arturskotar/self-balancing-robot/(commit log)

2026-06-26 Initial commit: self-balancing robot V1 PoC
    IMU-only (GY-91/MPU9250) PD balancing firmware for a 2-wheel inverted
    pendulum, plus WSL build/flash tooling.
    - balance_v2/: fixed-rate PID controller with motor-deadband feed-forward,
    no slew limiter, empirical setpoint, safety cutoff
    - flash.sh / sync.sh: usbipd attach + Windows->WSL sync + compile + upload
    - README, WSL setup/sync guides, BOM, MIT license
    [balance_v2.ino]
2026-06-26 docs: make README self-contained for the public repo
    Drop references to the local-only WSL helper scripts and guides; keep a
    plain arduino-cli compile/upload/monitor flow.
2026-06-29 Working full-state self-balancer: encoders, velocity & position feedback
    Evolves the V1 IMU-only PoC into a robot that stands up, holds level,
    holds its spot, and recovers from nudges.
    Firmware (balance_v2.ino):
    - Wire the Waveshare DCGM-3865 Hall encoders (half-quadrature: rising-edge
    ISR on each A channel, B read for direction; ~546 counts/rev). Per-side
    ENC_*_DIR signs (right is mirror-mounted).
    - Add wheel-velocity estimate (VF, low-pass filtered) and position (POS,
    revs from boot/home) from the encoders.
    - Velocity damping (Kv) to stop drift and position hold (Kx, clamped) to
    return toward home -> full-state feedback on top of the pitch PD.
    - Low-pass the D-term gyro rate (D_LP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
    [balance_v2.ino]
2026-06-29 Add stall cutoff to protect motors when wheels are wedged
    If the controller commands hard drive (|u| > STALL_U_MIN) but the wheels
    aren't turning (|VF| < STALL_VEL_MAX) for ~1 s, the bot is wedged/fallen
    and the motors are just stalling (heat, current) -- cut them until it frees
    up. A balancing wheel always moves while u is large, so only a genuine
    stall trips this; recovery is automatic once the wheels can turn again.
    Edges are logged (STALL / STALL cleared). Gated behind STALL_CUTOFF (set 0
    to disable). Not flash-tested yet.
    [balance_v2.ino]
2026-06-30 Checkpoint: stable balancer after gyro-axis fix + from-scratch D re-tune
    Root cause of the recent instability: pitch-axis rate moved to the Y gyro
    (library axis change), so the controller was reading getGyroX() ~= 0 and
    flying blind on rate. Fixed: gyroRate = -(getGyroY() - GYRO_Y_BIAS).
    Because every gain had been tuned against that dead rate signal, re-tuned
    the D path from scratch:
    - Kd 4.5 -> 0.3 (4.5 railed the motors once rate was real)
    - Added MPU9250 on-chip DLPF 41->20 Hz to kill a motor-vibration DC bias
    (+14 deg/s phantom that offset the pitch estimate and held motors at the
    stiction floor)
    - D_LPF 0.6 -> 0.8 to keep the D term off the residual fast vibration
    State at this c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
    [balance_v2.ino]
2026-06-30 Working cascade balancer: stands up, recovers from drags
    Replaced the direct Kv/Kx velocity/position terms with a proper cascade:
    encoders -> a slow LEAN setpoint that the inner pitch loop chases.
    leanRaw = -(Kpos*positionRev + Kvel*forwardVel), clamped + low-passed
    error = pitch - (BALANCE_SETPOINT + leanCmd)
    The cascade never worked before only because its inner loop was reading the
    dead gyro; with the gyro fixed it is hand-tunable (no LQR needed). Key tuning:
    - LEAN_LPF 0.95 -> 0.99: 0.95 (~100ms) was faster than the pendulum's
    non-minimum-phase wrong-way transient -> positive feedback -> runaway. 0.99
    (~500ms) keeps the outer loop slower than the transient.
    - Kvel 2.0 -> 4.0: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
    [balance_v2.ino]
2026-06-30 Coast band: motors rest when balanced (kills jitter + saves motors)
    Widened the coast dead-zone 0.15 -> 1.0 deg and stopped gating it on gyroRate
    (which is corrupted by motor vibration and never let the coast engage). Now:
    within 1 deg of the leaned target AND wheels stopped -> command exactly 0.
    Result is better than just "rest the motors": the jitter was a self-sustaining
    loop (motors buzz -> vibration -> gyro reads it as motion -> motors buzz). With
    the motors cut at balance, the vibration stops, the gyro goes quiet (RATE falls
    from +/-35 to ~0), and it stays settled. Telemetry shows long runs of U 0 with
    RATE ~0 and the wheels frozen -- motors fully off, no current/heat/battery drain.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
    [balance_v2.ino]
2026-06-30 docs: sync README + CONTROL_THEORY to the final cascade + coast-band design
    The docs had drifted far behind the firmware. Brought both in line with the
    shipped controller and folded in the hard-won lessons from the tuning saga:
    - Cascade control law now shows the outer-loop low-pass (LEAN_LPF) and the
    coast band; gain table updated (Kd 4.5->0.3, Kpos 3->1, Kvel 6->4,
    LEAN_CLAMP 6->5, +LEAN_LPF 0.99, +ANGLE_DEADZONE 1.0, +GYRO_Y_BIAS, +DLPF).
    - New theory: the IMU pitch-axis-on-gyroY gotcha (§4.2); why Kd is *small*
    here and the on-chip DLPF (§7.3); the coast band as a self-sustaining-jitter
    breaker (§7.4); timescale separation / why LEAN_LPF must be slow or it runs
    away (new §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
2026-08-12 docs: Teensy 4.1 migration plan — closes the Arduino era
    Captures the V2 migration design and this session's electrical findings:
    - Encoder confirmed DC3.3V/DC5.0V w/ built-in pull-up -> power from 3V3,
    direct connect, no level shifting.
    - IBT-2 PWM is 3.3V-marginal (BTS7960 threshold ref'd to 5V Vcc): buffer
    with 74HCT244 or bench-verify; enables tied to 5V.
    - Final 2-rail power architecture (5V: Teensy+IBT-2 / 3V3: encoders),
    single-point ground, cut VUSB<->VIN pad for flash-over-USB.
    - Benefits (FPU, hardware QuadEncoder, 8 UARTs), IntervalTimer balance
    ISR, feature architecture (CRSF/ELRS, planning, LIDAR, telemetry),
    and the reasoned "not FreeRTOS yet" recommendation.
    Co-Au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
2026-08-12 docs(teensy): flashing pipeline + Uno->Teensy pinout mapping
    Flashing (§4.1): verified arduino-cli COMPILES Teensy (teensy:avr:teensy41)
    but cannot UPLOAD it over usbipd — Teensy re-enumerates to VID 16C0:0478 in
    HalfKay bootloader mode, breaking the attach mid-flash. Resolved by keeping
    the sync->build-in-WSL model but uploading via the Windows Teensy loader
    (teensy_post_compile.exe) called from WSL. Implemented in flash.sh, which is
    board-aware (--uno/--teensy). (flash.sh stays gitignored: machine-specific.)
    Pinout (§3.1): full Uno->Teensy 4.1 map. Motors 6/9 + 22/23 (paired FlexPWM
    submodules), encoders 2/3/4/5 on hardware QuadEncoder ch1/ch2, IMU on Wire
    18/19. Pins chosen to leave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
2026-08-12 fw(teensy): remap motor + encoder pins to the Teensy 4.1 map (§3.1)
    Motors: LEFT 6/9 (FlexPWM2.2 A/B), RIGHT 22/23 (FlexPWM4.0 A/B) — was the
    Uno's 5/6/9/10. Fixes the "only one motor drives" bench symptom: the wiring
    followed the new map but the flashed firmware still had the old pins, so only
    the overlapping pins 6/9 carried signal and the right motor (22/23) was dead.
    Encoders: 2/3/4/5 (were 2/4/3/7). Still attachInterrupt half-quadrature (works
    on any Teensy pin); pins are also hardware-QuadEncoder-capable for the future
    x4 upgrade. Comment fix: power the encoder at 3.3V on Teensy, NOT 5V — the
    built-in pull-up would otherwise drive 5V into a 3.3V input and damage it.
    IMU unchange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
    [balance_v2.ino]
2026-08-12 fw(crsf): standalone ELRS/CRSF receiver test + control mapping
    Hardware-verified against a RadioMaster RP1 (ELRS 2.4GHz) bound to a TX16S,
    read on Serial1 (pins 0/1) @ 420000 8N1. Hand-rolled parser: 0xC8 frame sync,
    CRC8-DVB-S2 check, 11-bit channel unpack. No external library.
    Control mapping (TX16S):
    - CH1 (right stick L/R) -> TURN
    - CH2 (right stick U/D, self-centering) -> DRIVE direction (-1..+1)
    - CH3 (throttle, rests at bottom) -> speed CAP (0.35..1.0), never disables drive
    - CH6 SB -> ARM (up only), CH7 SC -> gain select (Kp/Kd/Kvel)
    - CH8 S1 -> live-tune knob, clamped to a safe window per gain
    - Link loss -> failsafe (drive=0, disarm)
    Prints DRIVE/TURN/ARM/TUNE + raw CH1-8 for ben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
    [crsf_test.ino]
2026-08-12 fw(rc_drive): open-loop RC wheel-drive test (differential mix, arm-gated)
    Wheels-off-ground validation of the radio->motor path before folding drive into
    the balancer. Differential mix (left=drive+turn, right=drive-turn), per-side
    deadband (the pins-6/9 motor is stiffer -> bigger stiction kick), 20 kHz PWM for
    quiet running, arm(SB) + link-loss motor kill. Drive/turn axes inverted to match
    the sticks (up=forward, right=right).
    [rc_drive.ino]
2026-08-12 fw(crsf_test): invert drive + turn axes to match the sticks
    Stick up = +forward, stick right = +right (both were inverted). Keeps the
    convention consistent across crsf_test / rc_drive / balance_v2.
    [crsf_test.ino]
2026-08-12 fw(balance): integrate CRSF kill-switch + live gain tuning
    crsf.h: minimal ELRS/CRSF reader on Serial1 (same parser verified in crsf_test),
    exposed as crsf::armed/gainSel/knob01/drive/turn.
    balance_v2:
    - KILL SWITCH: the balancer runs ONLY when armed (radio linked AND SB up).
    Disarm, radio-off, or link-loss -> motorRaw(0) instantly, integral + lean
    reset, re-home. Hardware-verified: SB off = dead, SB on = balances.
    - Live tuning: SC selects Kp/Kd/Kvel, S1 knob sets it within a safe band
    centered on the shipped value (knob center = shipped), pickup-style so flipping
    SC never jumps a gain. Telemetry prints ARM + live Kp/Kd/Kvel.
    Behavior change: no radio = no balancing (by design).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
    [balance_v2.ino, crsf.h]
2026-08-12 fw(balance): RC drive + steering (turn works; forward pending 3.3V->5V buffer)
    - Turn: differential on the per-wheel output (u +/- turnCmd), applied after the
    coast band -- WORKS (rotates in place). Balance is yaw-blind so it passes through.
    - Drive: lean-to-drive via the cascade outer loop. Drive stick -> target forward
    velocity; while driving the position hold is released (re-home) so station-keeping
    doesn't fight it. Coast band suppressed while commanding, else it swallowed the
    small drive lean.
    - Per-side deadband in the balancer too (pins-6/9 = 15, 22/23 = 11); crsf::speed()
    added for the CH3 speed cap.
    Forward drive does NOT roll yet: the balance loop's safe authority (~25 P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
    [balance_v2.ino, crsf.h]
2026-08-13 Rebuild drive as velocity-to-lean loop
    Assumption: best-practice balancing robots use driver velocity command through an outer PI/PID that outputs target lean; forward motion is validated negative on this chassis, so DRV -1 maps to negative target velocity and the velocity PI produces positive forward lean without direct motor feedforward.
2026-08-13 Raise wheel deadband for drive breakaway
    Assumption: the latest log shows the velocity-to-lean loop has the correct sign, but forward drive only produced U=1..3, which mapped to PWM in the teens with the old 15/11 deadband. Turning works because TURN_AUTHORITY adds about 25, reaching roughly 40/36 PWM, so use a 35 PWM per-wheel deadband floor as stiction compensation while leaving PID in control of sign and timing.
    [balance_v2.ino]
2026-08-13 Drive by direct lean target
    Assumption: for this chassis test, the pilot drive stick should command the balance PID target angle directly, while the PID remains solely responsible for motor effort. DRV -1 maps to positive forward lean, position hold is released while driving, and encoder velocity is logged only for observation rather than speed control.
2026-08-13 Restore measured motor deadband
    Assumption: the 35-PWM steady floor is amplifying small PID sign changes into roughly 70-PWM reversals. Restore the measured 15/11 per-wheel compensation so the inner balance loop can cross zero without a large relay-like kick.
    [balance_v2.ino]
2026-08-13 Blank IBT-2 inputs before reversal
    Assumption: rapid balance-effort sign changes can momentarily overlap or abruptly swap RPWM and LPWM. Force each powered reversal through both inputs low with a 2 us blanking interval, while leaving same-direction PWM updates delay-free.
    [balance_v2.ino]
2026-08-13 Set explicit 20 kHz motor PWM
    Assumption: balance_v2 should use the same known motor-carrier frequency as the validated rc_drive test. Configure every motor pin because Teensy pins 22 and 23 use separate PWM submodules; 20 kHz remains below the BTS7960 25 kHz limit.
2026-08-13 Log filtered rate and actual motor PWM
    Assumption: integer U telemetry hides the near-zero sign changes and deadband mapping suspected in the oscillation. Log floating-point controller effort, filtered D-term rate, and signed per-wheel PWM so the next test can distinguish sensor noise, control reversal, and motor-output behavior.
    [balance_v2.ino]
2026-08-13 Use bounded wheel breakaway pulses
    Assumption: loaded wheels may need about 35 PWM to start, but holding that as the permanent minimum creates a relay limit cycle. Apply it for 70 ms only after 120 ms of genuine idle, cancel it on PID reversal, then return to the measured 15/11 compensation.
    [balance_v2.ino]
2026-08-13 Calibrate gyro bias at startup
    Assumption: the MPU9250 zero-rate offset varies with unit and temperature, and a fixed -9 deg/s bias can leak into both pitch and derivative effort. Measure 400 motors-off samples, reject noisy calibration above 2 deg/s standard deviation, and retain -9 only as a fallback.
    [balance_v2.ino]
2026-08-13 Bound vibration-driven derivative effort
    Assumption: motor-on RATE spikes around 40-55 deg/s are largely vibration and can contribute 12-16 effort at Kd 0.3, repeatedly reversing the wheels. Cap only the D contribution at +/-8 while preserving proportional and total motor authority, and log DTERM for validation.
    [balance_v2.ino]
2026-08-13 Correct per-wheel deadband guidance
    Assumption: deadband measurements must remain per-wheel because the two motors have different breakaway thresholds; remove stale references to the deleted shared MOTOR_DEADBAND setting.
    [balance_v2.ino]
2026-08-13 Restore full derivative damping
    Assumption: the latest log proves the large RATE values are real body motion during 20-30 degree swings, not merely motor vibration. The +/-8 D-term cap therefore removed required braking authority; retain DTERM telemetry but restore the original Kd times filtered-rate response.
    [balance_v2.ino]
2026-08-13 Remove steady per-wheel PWM bias
    Assumption: the observed dominant physical right wheel corresponds to the side receiving the extra four-count deadband compensation. Use equal 11/11 steady floors so equal balance effort produces equal PWM; retain the equal bounded breakaway pulse for startup.
2026-08-13 Reject turn cross-axis during straight drive
    Assumption: the latest straight-drive log shows TRN around -0.20 to -0.25, creating enough differential effort to cancel one wheel while the other drives. Use an independent 0.30 turn deadzone while preserving the 0.15 drive deadzone and full intentional turn authority.
2026-08-13 Reduce direct drive lean authority
    Assumption: a persistent 6-degree target-angle shift is too aggressive for this chassis and makes full-stick drive dominate the inner balance loop. Start at 2 degrees and constrain live tuning to 1-3 degrees so movement remains recoverable.
2026-08-13 Log post-deadzone turn effort
    Assumption: raw TRN telemetry will still show the measured gimbal cross-axis even when the controller rejects it. Log TCMD separately so the next test proves whether differential motor effort is truly zero during straight drive.
2026-08-13 Increase bounded wheel breakaway pulse
    Assumption: equal 25-33 PWM commands with zero encoder motion mean the previous 35 PWM / 70 ms pulse was insufficient to break the loaded wheels free.
2026-08-13 Arm wheel breakaway on drive onset
    Assumption: balancing effort can already be active when the drive stick moves, so idle-only breakaway arming can miss the command transition and leave both loaded wheels below their movement threshold.
2026-08-13 Revert drive breakaway experiment
    Assumption rejected: forcing a 42 PWM breakaway pulse at drive onset disrupts the pitch controller and makes balancing unsafe; restore the prior idle-only 35 PWM / 70 ms behavior.
    [balance_v2.ino]
2026-08-13 Restore symmetric balance output mapping
    Assumption: timed breakaway pulses and per-wheel deadband differences were contaminating the neutral pitch loop; restore one measured 11 PWM floor for both wheels while retaining differential steering and reversal blanking.
    [balance_v2.ino]
2026-08-13 Restore idle velocity damping
    Assumption: validated forward-negative encoder motion requires positive Kpos and Kvel feedback to request an opposing lean; applying this only at neutral restores recovery damping without fighting direct drive lean.
2026-08-13 Add end-to-end balance telemetry
    Assumption: preserving explicit 20 kHz, 8-bit setup on all four hardware FlexPWM pins is valid, while logging raw sensors, PID terms, wheel efforts, encoder deltas, lean components, radio inputs, and controller state will isolate any remaining regression.
2026-08-13 Rebuild drive as a setpoint-tracking cascade; fix PWM frequency
    The forward-drive failure had two root causes, both found by diffing
    against 9f13160 (the last known-good balance) and reading the BTS7960
    datasheet rather than inferring from behaviour.
    1. PWM frequency. The BTS7960 has a large input->output turn-on delay
    (datasheet 4.2.3): ~5.5us + ~2.5us rise at the IBT-2's 10k slew
    resistor, so pulses shorter than ~8us produce no output at all. At
    the Teensy default 4482 Hz one PWM count is 0.875us, so ~9 counts
    clear it -- matching the measured deadband of 11. At the 20 kHz set
    in a7480d9 one count is 0.196us, so ~41 counts are needed --
    matching the measured "~40 PWM to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
    [balance_v2.ino]
2026-08-13 Add outer-loop kill switch to isolate the forward runaway
    First armed run diverged: over 2.8 s PITCH climbed -0.65 -> +7.83 while
    TARGET fell -3.29 -> -6.00, so the gap widened monotonically from 1.6
    to 13.8 deg. Nothing oscillated -- every quantity moved one way. The
    inner loop was commanded to lean back to -6 deg and the body went to
    +7.8 instead. The sticks were never touched (DRAW/TVEL zero on every
    line), so this was not a drive test.
    That leaves two candidate faults and the log cannot separate them:
    a) The outer loop gain is too high and it drags the target away
    faster than the inner loop can follow. Kvel = 4.0 means 0.68 rev/s
    alone commands 2.7 deg of lean, over half of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
    [balance_v2.ino]
2026-08-13 Confirm all four sign chains from the hand-tilt test
    The previous commit read the 2026-08-13 log as an autonomous runaway.
    It was not: the run was a manual sign-verification with the sticks
    untouched, so the rising PITCH was the operator tilting the robot, not
    a divergence. The off-axis gyro activity agrees -- GZ swings +14.4 to
    -11.5 and GX reaches 11.7, which a robot rolling on a flat floor would
    not do. The controller driving the wheels forward under a growing
    forward tilt is the correct response, not a fault.
    Verified from that log:
    encoders rolling forward counts UP on both wheels (556 / 515), so
    forward = positive. The ENC_*_DIR flip was right.
    inner loop PITCH +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
    [balance_v2.ino]
2026-08-13 Restore per-side motor deadband (11 L / 13 R)
    The 2026-08-13 log shows the wheels need different breakaway floors.
    Summing per-window encoder deltas, the left wheel ran 21% ahead of the
    right below ~23 PWM but only 4% ahead above ~30 PWM. A gap that closes
    once both wheels are moving is a deadband difference, not a gain
    difference, and it matches the earlier bench measurement of ~11 L /
    13 R. Symptom it fixes: veering while creeping, tracking straight at
    speed.
    mapEffortToPwm() now takes the floor as an argument rather than reading
    a single global. The compensation stays STATIC -- no time-dependent
    breakaway pulses back into the pitch loop, which is what made the
    abandoned balancing-tuned b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
    [balance_v2.ino]
2026-08-13 Correct DEADBAND_TEST to measure loaded breakaway, not free-spin
    The first stick-engaged run showed the cascade working end to end: the
    outer loop asked for 4.4 deg of lean and the inner loop delivered it to
    within 0.69 deg. The robot still did not move -- ENC L 8 R 4 with zero
    per-window deltas for seven seconds while leaning.
    The log brackets why. PWM 15/17 produced zero encoder counts while the
    robot bore its own weight, and PWM 12/14 likewise once the lean was
    reached, but 34/39 during a turn rolled the wheels freely. So loaded
    breakaway is somewhere in 17..34, against deadbands of 11/13.
    Those 11/13 came from DEADBAND_TEST, whose instructions said to run it
    with the wheels off the gro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
    [balance_v2.ino]
2026-08-13 Fix inverted drive axis at the source in crsf.h
    Confirmed on hardware: pushing the stick forward gives DRAW -1.00, so
    crsf::drive() was returning -1 for forward -- the opposite of the
    contract stated in its own comment one line above ("Up = +forward").
    That surfaced as TVEL -0.60, a reverse command, while the pilot was
    pushing forward.
    On this TX16S setup CH2 reads above 1500 when the stick goes forward, so
    the raw (us-1500) term is already positive and the extra negation was
    wrong. Removed it.
    Fixed in crsf.h rather than by flipping DRIVE_SIGN so that drive() now
    matches its documented contract and DRIVE_SIGN stays a pure chassis-
    wiring knob. Flipping both would have left two negations c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
    [balance_v2.ino, crsf.h]
2026-08-13 Split the friction floor by wheel motion; fix setpoint windup
    The stick-engaged run confirms the drive axis fix -- forward stick gives
    TVEL +0.32 and TARGET leans forward from -3.21 to -1.70 -- and shows
    exactly why nothing rolls.
    Drive commanded 11/13 rising to 13/15 and the encoders never moved. The
    turn, in the same log, commanded 14..25 on one side and that side rolled
    immediately. Breakaway under load is around 16..20, and drive never
    reaches it; the turn only works because the differential adds to one
    side and pushes it over. Stick-slip is severe: PWML 19 gave DL 0 one
    window, PWML 16 gave DL -6 the next.
    So the two deadband measurements that looked contradictory are both
    right, they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
    [balance_v2.ino]
2026-08-13 Judge wheel motion by net displacement, not by any tick
    The wheelMoving detector added in the previous commit is wrong under
    stick-slip, which is exactly the regime it was built for. It marked a
    wheel as moving if the encoder changed at all within 50 ms. During
    stick-slip the encoder emits a continuous stream of +1/-1 ticks that sum
    to nothing, so the test read "moving" and selected the low Coulomb floor
    at precisely the moment the wheel was stuck and needed the static
    breakaway kick.
    The oscillation log shows it plainly: DL alternated -1/+1 for four
    seconds of full drive command, ENC L travelled from -21 to -31 in total,
    and DBL reported 11M throughout. The 18 static floor never engaged on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
    [balance_v2.ino]
2026-08-13 Set measured breakaway floors: 15 left, 27 right
    Loaded DEADBAND_TEST result. The right wheel needs nearly double the
    left to break away:
    PWM 14 -> dL -1 dR -1
    PWM 15 -> dL -6 dR -1 left breaks free, then accelerates
    PWM 20 -> dL -39 dR -3
    PWM 26 -> dL -95 dR -4 right still dead
    PWM 27 -> dL -119 dR -8 right finally breaks free
    The equal 18/18 floors straddled that gap -- left above its threshold,
    right below its own -- which accounts for the entire drive history in
    one fact. Commands of 13..15 moved nothing. The stick-slip oscillation
    was the left wheel intermittently breaking free near 15..18 while the
    right stayed locked. Turning worked only because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
    [balance_v2.ino]
2026-08-13 Filter drivetrain resonance before pitch control
    Lower the MPU9250 gyro and accelerometer DLPFs to 10 Hz after telemetry placed the motor-driven resonance at the previous 20 Hz corner. Return DEADBAND_TEST to normal operation after recording the loaded thresholds.
    Assumption: the added sensor delay remains compatible with the near-perfect neutral balance and suppresses more derivative noise than phase margin it costs; revert this commit first if neutral recovery degrades.
    [balance_v2.ino]
2026-08-13 Add bounded torque assist at drive onset
    On a fresh non-zero drive command, add up to four common-mode effort units in the direction currently requested by the inner pitch loop. End the assist when both encoders confirm net motion or after 250 ms, and expose START/BOOST telemetry.
    Assumption: the hand-push result means the cascade and moving-wheel authority are sound, while the remaining launch failure is insufficient margin over loaded static friction, especially on the right drivetrain. The inner balance loop remains the sole authority over motor direction.
    [balance_v2.ino]
2026-08-13 Delay drive assist until the lean is established
    Arm launch assist on a fresh drive command, wait until the cascade has established the requested lean and the body is near that target, then enforce a short axle-effort floor in the requested travel direction. Abort on excessive pitch error or rate, release on measured forward motion, and expose wait/push phases in telemetry.
    Assumption: the latest log shows the cascade reaching about 2.9 degrees of commanded lean while the old 250 ms assist has already expired; derivative-driven direction reversals then leave forward velocity near zero. A delayed one-shot pulse should reproduce the successful hand push without changing standing balance or pu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
    [balance_v2.ino]
2026-08-13 Correct encoder feedback polarity from autonomous drive data
    Flip both per-side encoder multipliers so a physical forward wheel catch reports positive counts, matching positive target velocity and the cascade equations. Correct the stale ISR comment and print the target/encoder/PWM sign convention at startup.
    Assumption: the inner balance direction is already validated and negative PWM is its physical forward catch. In the latest autonomous log, sustained negative PWM produces negative encoder deltas while positive-PWM rebound produces positive deltas, proving the current -1/+1 encoder multipliers invert physical forward. The earlier hand-tilt test was confounded by operator motion and coul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
    [balance_v2.ino]
2026-08-13 Restore neutral target after drive release
    Re-anchor the position setpoint to measured position when the drive stick returns to neutral, preventing a failed launch from leaving the position error pinned at its clamp. Require 100 ms of sustained commanded-direction velocity before launch assist exits, so an oscillation spike cannot masquerade as successful breakaway.
    Assumption: the latest log shows clean idle balance before drive, then PERR remaining at 0.499 after release while STATE COAST suppresses motor output. It also shows START W disappearing after a brief velocity reversal rather than sustained travel. The 1.0-degree coast band is not changed because it is disabled during STATE DRIV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
    [balance_v2.ino]
2026-08-13 Limit derivative kick during drive breakaway
    Assumption: the latest no-motion log shows the outer lean target is correct, while vibration-driven D spikes dominate P and reverse the axle before sustained motion begins. Preserve full derivative damping for neutral balance, confirmed rolling, and larger recovery errors.
    [balance_v2.ino]
2026-08-13 Gate drive launch on measured body lean
    Assumption: launch assist was entering from the commanded lean while the chassis remained nearly upright, so the forward pulse arrived before the body was in a catchable forward lean and immediately triggered a rate abort. Require measured lean and expose the latched launch exit reason.
2026-08-13 Prevent launch assist from reversing balance effort
    Assumption: the captured START P sample proves the breakaway floor changed a +4.2 recovery command into -4.0, causing the immediate pitch reversal and gyro abort. Permit launch assist only when the inner loop already commands the requested travel direction.
    [balance_v2.ino]
2026-08-13 Correct encoder polarity from unpowered push test
    Assumption: the user-confirmed physical forward push with both motor PWMs at zero is authoritative; it produced negative counts on both transformed encoders, proving both encoder direction constants were inverted. Flip them so physical forward, target velocity, and measured velocity are all positive.
    [balance_v2.ino]
2026-08-13 Increase gated drive launch authority
    Assumption: the latest ground log is authoritative: after the body reached the requested forward lean, the existing launch floor produced about -19/-31 PWM for 200 ms but neither encoder advanced. Raise only the gated launch effort from 4 to 10, yielding about -25/-37 PWM, while leaving neutral balance, rotation, PID gains, and normal output mapping unchanged.
2026-08-13 Keep drive launch armed through balance recovery
    Assumption: the reverse-push/forward-stick log is authoritative. The cascade correctly commanded maximum forward lean, but the inner loop needed about two seconds to recover a 14-15 degree backward lean; LAUNCH_WAIT_MS expired just before the body reached the safe forward-catch state. Keep WAIT_LEAN armed while the stick remains commanded and rely on the existing lean, error, rate, direction, and release gates to decide when the bounded assist may run.
    [balance_v2.ino]
2026-08-13 Count launch assist only while direction is eligible
    Assumption: the latest reverse-push/forward-stick log is authoritative. WAIT_LEAN persisted as intended, but PUSH began during a brief eligible sample, then spent its entire 200 ms timeout while the inner PID pointed backward and BOOST remained zero; it expired exactly when forward catch effort appeared. Replace wall-clock timeout with a 40-tick eligible budget, defer back to WAIT_LEAN when PID direction disagrees, and log the remaining BTK budget.
    [balance_v2.ino]
2026-08-13 Re-anchor drive trajectory at pilot takeover
    Assumption: stale station-keeping position error must not oppose a fresh drive command. The latest forward-push log showed negative PERR holding the lean command backward for about 700 ms after forward stick, so reset the position target to measured position at command and direction transitions while preserving normal cascade integration afterward.
    [balance_v2.ino]
2026-08-13 Give the velocity loop persistent drive authority
    Assumption: the latest tests show that target lean is reached but the PD angle loop then averages to nearly zero axle torque, so a bounded velocity-error torque term is required after the requested lean is safely established. Keep neutral balance unchanged, never stack with launch assist, and leave overspeed braking to the angle cascade.
    [balance_v2.ino]
2026-08-13 Hold drive torque through normal pitch motion
    Assumption: the latest log shows VTRQ contributes useful forward effort but the strict 10 deg/s engagement gate drops it on nearly every intervening sample, turning the supposedly persistent term into another pulse train. Engage under the original strict conditions, then retain it within the existing wider balance abort envelope and release it on unsafe motion, lost lean, overspeed, command release, or direction change.
2026-08-13 Restore full pitch damping during drive
    Assumption: the latest held-stick log shows the drive torque path now contributes, but pitch rate grows to roughly +/-50 deg/s while the drive-only derivative limiter clips a required +/-14 effort to +/-3. Neutral balance already uses the full derivative successfully, so preserve the same inner PD law during drive and test this independently of gains, deadbands, signs, and launch behavior.
2026-08-13 Disable redundant drive launch pulse
    Assumption: the safety-gated persistent velocity effort now reaches the measured breakaway range, so the one-shot launch pulse is redundant. The latest inertia log showed it firing after speed recovery and injecting another kick into an already-moving catch. Keep neutral balancing, signs, gains, and full derivative damping unchanged.
2026-08-13 Remove post-PD drive torque from the cascade
    Assumption: the stalled-drive oscillation is caused by the inner angle loop cancelling the safety-gated velocity effort. With VTRQ near -6 and Kp 2, cancellation requires about -3 degrees of error, beyond the 2.5-degree hold gate, so the term repeatedly disengages and re-engages. Keep the legacy path compile-disabled for A/B comparison; do not change neutral PID, signs, deadbands, or PWM.
    [balance_v2.ino]
2026-08-13 Increase commanded drive lean within existing limit
    Assumption: the latest stalled-drive log shows VERR near 0.6 rev/s producing only about 3 degrees of requested lean, while the inner P term remains smaller than the drivetrain-induced derivative ring. Double velocity-to-lean gain only during an active translation command, retain Kvel 4 at neutral, and preserve the existing slow lean filter and 5-degree clamp.
    [balance_v2.ino]
2026-08-13 Add a non-repeating breakaway pulse
    Assumption: the latest log proves the cascade reaches and holds its 5-degree drive target while stopped, but alternating inner-loop effort never sustains either PWM direction long enough to cross loaded stiction. Apply one measured 20-effort pulse only after the lean is established and settled, cap it at 200 ms, abort on lost lean/error, and enter a done state on every exit so it cannot re-fire during a held command.
    [balance_v2.ino]
2026-08-13 Give the inner loop drive-specific wheel authority
    Assumption: translation is weak because the outer loop only requests lean and Kp 2 turns the resulting small angle error into roughly 5-10 effort, while turning injects up to 25 effort directly. Blend inner proportional gain toward 4 only during commanded translation so larger catch errors can produce turn-class common-mode wheel power; retain Kp 2 and Kd 0.3 at neutral.
    [balance_v2.ino]
2026-08-13 Arm breakaway assist through the RC ramp
    Assumption: the launch pulse never fired because a normal stick gesture first produced TVEL 0.14, below the 0.30 strong-command threshold, and permanently entered LAUNCH_DONE before full stick arrived. Keep the launch state waiting through sub-threshold samples and require the strong threshold only when starting the pulse; moving authority and neutral balance remain unchanged.
2026-08-13 Raise drive-specific catch authority
    Assumption: Kpeff 4 remains too weak against strong longitudinal inertia because the latest drive log peaks at only 15.58 common-mode effort, below the turn mixer's 25 despite a 110 PWM ceiling. Raise only the translation-specific proportional target to 6 so 4-6 degree catch errors produce 24-36 effort; preserve neutral Kp 2, Kd, lean limits, signs, and launch behavior.
    [balance_v2.ino]
2026-08-13 Decouple drive catch authority from speed cap
    Assumption: the speed knob should limit requested velocity, while full stick must retain the inner loop authority needed to catch the resulting lean.
2026-08-13 Keep launch assist subordinate to balance
    Assumption: breakaway compensation may strengthen an inner-loop command in the requested direction, but must never reverse an opposing balance correction.
    [balance_v2.ino]
2026-08-13 Reduce drive damping near the commanded lean
    Assumption: the large alternating gyro-rate term near a tracked drive angle is vibration-driven and masks proportional drive authority; full neutral damping must return smoothly by three degrees of tracking error.
    [balance_v2.ino]
2026-08-13 Lower near-target drive derivative gain
    Assumption: the remaining launch oscillation is caused by vibration-driven derivative effort still cancelling proportional drive authority near the commanded angle, while full Kd above three degrees preserves push recovery.
    [balance_v2.ino]
2026-08-13 Add damping to the established drive response
    Assumption: after derivative attenuation restored drive authority, the remaining held-stick oscillation is an underdamped pitch response, and a 0.05 near-target Kd preserves authority while damping it.
    [balance_v2.ino]
2026-08-13 Restore the drive-authority derivative floor
    Assumption: increasing near-target Kd from 0.03 to 0.05 did not reduce the held-stick oscillation and reintroduced larger rate-driven floor reversals.
    [balance_v2.ino]
2026-08-13 Suppress friction-floor chatter during drive
    Assumption: the remaining held-stick oscillation is sustained when sub-3 PID effort reversals are expanded into full per-wheel deadband compensation, while larger corrections provide the required inertia authority.
    [balance_v2.ino]
2026-08-13 Revert the symmetric drive output gate
    Assumption: zeroing small effort in both directions is invalid because zero PWM brakes the geared drivetrain and lets the robot remain statically parked at the saturated lean target.
    [balance_v2.ino]
2026-08-13 Bias stalled drive effort without masking balance
    Assumption: after the leaned target is reached, gearbox friction can park the robot at zero PID effort; a minimum same-direction stiction torque plus suppression of only tiny opposing floor kicks will initiate rolling while preserving larger balance corrections.
    [balance_v2.ino]
2026-08-13 Raise the stalled-drive stiction bias
    Assumption: the 1.0 effort bias lands at the measured breakaway edge and cannot establish rolling before the pitch loop recovers; 3.0 provides a small margin while the existing near-target, velocity, and full-correction safety gates remain in force.
    [balance_v2.ino]
2026-08-13 Hold commanded torque through safe launch error
    Assumption: with DRIVE_KP=6, normal sub-1.25-degree tracking error creates 3.4-6.4 effort recovery pulses that escape the old 3.0 gate and cancel breakaway torque; suppressing up to 7.0 only inside the existing stalled-drive safety window should establish rolling while larger balance corrections remain untouched.
    [balance_v2.ino]
2026-08-13 Remove the stalled-drive output relay
    Assumption: the alternating drive response already crosses both measured friction floors, so forcing and sign-clamping effort around the zero crossing reinforces the observed 5 Hz limit cycle instead of solving breakaway.
    [balance_v2.ino]
2026-08-13 Restore damping across the drive mode
    Assumption: the measured 5 Hz, 1.5-degree oscillation is underdamped because DRIVE_KP=6 and DRIVE_KD=0.03 leave the rate term about six times too small; Kd=0.20 should damp the mode while preserving the drive-specific proportional authority and the neutral Kd=0.30 behavior.
    [balance_v2.ino]
2026-08-13 Remove saturated drive velocity gain
    Assumption: the drive-only Kvel multiplier feeds encoder ripple back into a lean request already clamped at five degrees, sustaining the remaining sign reversals; using the neutral Kvel gain should keep the outer loop linear while DRIVE_KP=6 retains inner-loop authority.
    [balance_v2.ino]
2026-08-13 Fix drive launch assist direction
    [balance_v2.ino]
2026-08-13 Add clamped drive velocity integral
2026-08-14 Add gentle velocity trim while driving
2026-08-14 Define velocity trim abort rate
2026-08-14 Increase gentle velocity trim
2026-08-14 Gate velocity trim during pitch recovery
2026-08-14 Raise outer-loop authority above the measured breakaway lean
    The 2026-08-14 stalled-drive log held full stick for 1.9 s with POS flat at
    0.535 +/- 0.005 -- zero travel against 1.14 rev commanded. The cause was an
    arithmetic ceiling, not a tuning shortfall: all three lean terms were capped
    independently, so the loop could not ask for more lean however long the stick
    was held.
    LEAN POS 0.50 PERR pinned at POS_ERROR_CLAMP 0.5, times Kpos 1.0
    LEAN VEL 1.80 Kvel 3.0 * velError, and with the wheels stopped velError
    is identically targetVel -- capped by construction
    LEAN VELI 0.80 saturated at VEL_I_CLAMP after 0.6 s, constant thereafter
    -------------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
    [balance_v2.ino]
2026-08-14 Bound the stalled-drive lean ramp after the ceiling theory failed
    Bench test of 85a778d falsified the premise it was built on. Earlier logs showed
    the robot motionless at leans of +0.50 and -3.7 deg, which was read as a friction
    threshold near 3.7 deg that the loop's 3.10 deg lean ceiling could never reach.
    Lifting the ceiling to 10 deg disproved it: the run reached a COMMANDED lean of
    8.4 deg and an ACTUAL pitch of 12 deg, and the wheels still netted +7 encoder
    counts over 3.1 s -- in the wrong direction, against a backward command. POS sat
    flat at 0.003 throughout. A robot stationary at lean X proves the threshold is at
    least X, not equal to X.
    The authority changes themselves worked exac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
    [balance_v2.ino]
2026-08-14 Fix the outer-loop hunt, and add full-rate capture plus a static lean test
    Two oscillations have been conflated. Separating them:
    SLOW HUNT (~1 s) outer loop. Lean builds, robot accelerates, velError closes,
    lean collapses, friction decays the speed, lean rebuilds.
    "Reaches the lean, forgets it, balances, again and again."
    FAST RING (5-35 Hz) inner loop. The PWM sign chatter that stops the wheels
    netting any travel.
    Evidence for the hunt, from the MS 16064-18764 segment: the robot held ~0.5 rev/s
    for 2.7 s with VERR 0.03-0.11 and LEAN CMD settled at 0.14-0.24 deg -- a correct,
    tiny cruise lean. Then VF fell 0.51 -> 0.21 -> 0.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
    [balance_v2.ino]
2026-08-14 Record two findings from the 2026-08-14 bench run
    Comments only; no behaviour change.
    1. VEL_I_ROLL_MIN is a catch-22. The gate requires rolling before the velocity
    integral may build, but the integral existed to help start the roll, so on a
    stalled drive VELI sits at 0.01 and contributes nothing. Measured ceiling:
    LEAN POS 3.00 + LEAN VEL 1.26 + VELI 0.01 = 4.27 deg (RAW read 4.10-4.47).
    LEAN_CLAMP 6.0 never binds; POS_ERROR_CLAMP binds again. The anti-windup
    argument still holds in isolation -- the fix is to let it accumulate while
    stalled and RESET on breakaway, not to block it beforehand.
    2. DRIVE_VELOCITY_EFFORT is enabled despite being documented as A/B-only, and it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
    [balance_v2.ino]
2026-08-14 Let the velocity integral build while stalled; disable the legacy trim
    Acts on the two findings recorded in bef0275.
    - Velocity integral: VEL_I_ROLL_MIN becomes a breakaway EDGE DETECTOR instead
    of an integrate gate. The integral now accumulates freely while stalled --
    which is when the extra lean is wanted -- and is discarded on the stall ->
    rolling transition, since whatever accumulated there was fighting stiction
    rather than trimming a cruise. Keeps the anti-windup property (no stiction
    wind carried into cruise) without the catch-22 of requiring the roll it was
    meant to start. Ramp is ~0.25 deg/s at full stick; raise KVEL_I if too slow.
    - DRIVE_VELOCITY_EFFORT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
    [balance_v2.ino]
2026-08-14 Arm the static lean test and switch the inner loop to D-on-error
    STATIC_LEAN_TEST 0 -> 1, and the lean is now applied continuously whenever the
    robot is armed rather than scaled by the stick, so the body holds a lean it
    should be falling out of for as long as SB is up. SB remains the bail-out.
    Two side effects the mode has to force, or the measurement destroys itself:
    - Coast band suppressed. With no stick, `commanding` is false, so the band
    would zero u the instant the body reached the commanded lean -- exactly when
    the measurement starts.
    - Burst capture arms on the ARM transition instead of the drive edge, since
    there is no drive edge in this mode. SB up = soft-start + 2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
    [balance_v2.ino]
2026-08-14 Set the drive envelope from the measured breakaway lean
    The static lean test plus the 200 Hz burst capture found the number this whole
    investigation was missing, and it was a FLOOR, not a ceiling.
    BREAKAWAY LEAN IS ~3.4 DEG. At a commanded 3.0 the robot travelled 0.245 rev --
    but only during the stand-up overshoot, while the ACTUAL lean was 6.5-7.6. As the
    inner loop settled the pitch onto its commanded 3.0, speed decayed with it:
    LEAN ACT 7.6 -> VF 0.20 LEAN ACT 4.1 -> VF 0.06
    LEAN ACT 6.5 -> VF 0.18 LEAN ACT 3.4 -> VF 0
    LEAN ACT 5.0 -> VF 0.11
    Every earlier drive log had a MEAN achieved lean of ~2.9-3.0, a few tenths under
    threshold. The commanded value looked adeq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
    [balance_v2.ino]
2026-08-14 Retire the static lean test; size the outer loop to the measured breakaway
    The static lean test is done. It answered all three questions it was built for:
    1. THE DRIVETRAIN WORKS. One run produced POS 0.000 -> 2.134 -- 2.13 rev of
    sustained monotonic travel at up to VF 0.65 rev/s. Closed.
    2. Breakaway is ~6-7 deg. The 3.4 deg figure from the first run was a coast
    artefact, measured while decelerating out of a stand-up overshoot.
    3. THE OBSTACLE IS THE STATIC/KINETIC FRICTION GAP. The same 6.0 deg command gave
    opposite outcomes on consecutive runs -- one stalled with POS frozen and
    LEAN ACT ~6.2, the other broke away and ran to LEAN ACT 18.9 with ERR 12.9 --
    and the second run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
    [balance_v2.ino]
2026-08-14 Cut time-to-breakaway so a standing start can reach the friction threshold
    FORWARD DRIVE WORKED for the first time. MS 32585-35909: POS 0.777 -> 1.371,
    0.59 rev in 3.3 s, with PWML/PWMR negative on all 33 samples -- no sign reversal,
    against every earlier log where it flipped every 100 ms. DFILT stayed inside +/-3
    throughout; the oscillation is simply absent while the wheels roll.
    The handover worked too. LEAN CMD climbed to 5.23, the robot accelerated, VERR
    closed from 0.20 to -0.00, and the lean came back down to ~4.8 on its own. That
    is the mechanism the static/kinetic bistability requires, working.
    What still fails is a FRESH STANDING START, seen on the reverse attempt from
    MS 37020: L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
    [balance_v2.ino]
2026-08-14 Bisect out the drive gain schedule: the 8.5 Hz stall is a limit cycle
    The 200 Hz burst capture finally resolved the stall oscillation, and it is
    neither of the things 100 ms telemetry suggested. It is a clean 8.5 Hz limit
    cycle created by the drive gain schedule and sustained by the deadband floor.
    Evidence from the 400-sample burst (armed on the drive rising edge):
    * Period: positive-run starts at i = 202,226,250,273,296,319,343,366 give
    deltas 24,24,23,23,23,24,23 = 23.4 samples = 117 ms = 8.5 Hz. Half-period
    is ~12 ticks, which also rules out the sign-hysteresis fix that was on the
    table -- 60 ms of held wrong-sign output is not survivable in a balancer.
    * Not chatter: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
    [balance_v2.ino]
2026-08-14 Make the launch assist continuous: friction feedforward aimed by velError
    The bench log showed the only mechanism that has ever moved this robot, and it
    is the launch assist, not the cascade. MS 33390-33590:
    MS DL DR VF START BTK
    33290 -1 0 0.01 W 40
    33390 +1 +3 0.06 W 40
    33490 +1 +5 0.09 P 36 <- assist PUSH fires
    33590 +4 +4 0.12 P 16
    33690 0 +1 0.03 C 11 <- released early, driveRollingConfirmed
    33790 -1 -2 -0.04 C 11
    It rolls while the pulse is on and dies within 200 ms of it ending. The assist
    exited with 11 ticks still on the clock: it saw 0.12 rev/s, declared bre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
2026-08-14 Fix the friction feedforward sign: aim it at u, not velError
    The velError-aimed bias from the previous commit had the sign backwards. The
    bench run confirmed both halves of that: the oscillation is gone, and the robot
    still cannot move.
    WHAT WORKED. u in the 200 Hz burst is a smooth curve, |rate| stays under 9, and
    there is nothing at 9 Hz anywhere in 400 samples. Taking the floor off the AC
    path really was what killed the limit cycle, so that diagnosis stands.
    WHAT BROKE. At burst i=399, u = +20.4 with FFB = -0.97 and floors 15/27:
    left : 15 * (-0.97) + 20.4 = +5.9 -> pwmL +6
    right: 27 * (-0.97) + 20.4 = -5.8 -> pwmR -4
    The bias and the PD cancel to nearly nothing, and b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
    [balance_v2.ino]
2026-08-14 Split the friction feedforward into LAUNCH and CRUISE phases
    The u-aimed bias got the lean up for the first time and then had nothing left to
    push with. Bench 2026-08-14:
    LEAN ACT reached 6.4 -> 9.9 deg tracking LEAN CMD 6.1 -> 8.5, |ERR| <= 1.5.
    Every earlier run had LEAN ACT pinned at -2.4 while the command climbed to 6.5.
    The body finally goes where it is told.
    POS stayed at 0.21 for the whole 1.3 s window. Lean up, wheels stopped.
    The burst explains it. u crosses zero at i = 46, 148, 241 -> ~195 samples = ~1 Hz,
    and across the whole capture u has essentially NO DC; it just swings +/-7.
    FRICTION_FF_LPF sits at 0.64 Hz, right on that, so FFB chased the swing (-0.62 to
    +0.65) rat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
2026-08-14 Overdrive the friction feedforward to the launch-assist magnitude
    The robot drove for the first time -- POS -0.625 -> 1.164, 1.79 revolutions -- but
    needed ~11 deg of lean to come unstuck, and climbing to 11 deg is what feels slow.
    The ramp itself is doing what it was sized to do; it just runs out. Measured:
    MS 29405 -> 29705, VELI 4.20 -> 5.00 5.0 deg/s
    MS 29705 -> 30205, VELI clamped at 5.00 1.9 deg/s
    The 5.6 deg/s target is real, it only lasts until the integral saturates ~1.5 s
    in, after which just Kpos*Vmax = 2.4 deg/s remains and the last few degrees crawl.
    Raising KVEL_I would not fix that -- it reaches the same clamp sooner and total
    time is set by the clamp value,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
    [balance_v2.ino]
2026-08-14 Let the robot attempt a stand-up, bounded by a give-up timeout
    Requested: recover from the logged "laying" pose. That pose is LEAN ACT 31.60 deg
    -- 1.6 deg past FALL_CUTOFF_DEG 30 -- so the fall latch had tripped and the robot
    was forbidden from even trying. The cutoff was the only thing in the way: at 31.6
    deg of error the PD asks for Kp*31.6 = 63 PWM against a 110 ceiling, authority it
    already has.
    FALL_CUTOFF_DEG 30 -> 45
    Beyond ~45 deg the accel pitch gets ambiguous and it really is on its back, so
    that is the new line.
    A stand-up attempt has to be BOUNDED or it cooks the motors against whatever the
    robot is lying on. Above ~39 deg of error the existing saturation latch already
    cov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
    [balance_v2.ino]
2026-08-14 Stop the friction FF phase from chattering; confine the boost to launch
    The boost re-introduced the oscillation, and the log shows the mechanism is the
    PHASE GATE, not the boost's magnitude. Consecutive 100 ms samples:
    45100 FFP C FFB +0.94 LEAN ACT -5.70 PWM +48/+63
    45200 FFP L FFB -0.83 LEAN ACT 0.60 PWM -36/-37
    45300 FFP C FFB +0.95 LEAN ACT -6.34 PWM +46/+48
    45401 FFP L FFB -0.69 LEAN ACT -0.22 PWM -28/-30
    LEAN ACT was ringing -6.6..+0.6, a 7 deg swing, while the enter/exit pair was
    3.0/1.5 -- a 1.5 deg band sitting entirely inside the ring. The phase flipped every
    tick, and because LAUNCH and CRUISE push in OPPOSITE directions by design, every
    flip is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
    [balance_v2.ino]
2026-08-14 Fix the one-wheel stall: common FF floor, and let CRUISE fall back to LAUNCH
    Two defects, one of them introduced by the previous commit.
    1. PER-WHEEL FLOOR IN THE FEEDFORWARD PATH. The FF bias is a common-mode drive
    command, but each wheel was scaling it by its own deadband. Because the FF can
    OPPOSE u, that differential lands as a net-zero wheel. Bench 2026-08-14, u =
    -28.50, FFB = +0.99, DBL 11M, DBR 27S:
    left : 11 * 0.99 - 28.50 = -17.6 -> PWML -17
    right: 27 * 0.99 - 28.50 = -1.8 -> PWMR -1
    ENC L ran 10 -> 267 while ENC R sat at 20. It is also self-reinforcing: the
    stopped wheel keeps the larger STATIC floor (27 not 13), which cancels more of u,
    which keeps it stopped.
    N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
    [balance_v2.ino]
2026-08-14 Let the lean command track the launch, and lead the LAUNCH->CRUISE gate
    The launch rotates the body about 20x faster than the outer loop's lean ramp, so
    the inner loop spent the whole launch fighting it. Bench burst, forward drive:
    i=0..5 PWM +47 (launch), pitch -3.52, rate 0
    i=6..15 rate 9 -> 93 deg/s, pitch -3.6 -> -0.6
    i=16 leanToward crosses 3.0 -> CRUISE, PWM +16 -> -60 in ONE TICK
    LEAN CMD was still 0.38 and climbing at 5.6 deg/s while the body did 100 deg/s.
    The inner loop therefore saw the body running away from a stationary target and
    drove u to -31 OPPOSING the launch, and the handover then reversed 76 PWM counts
    into a body already rotating at 100 deg/s. Peak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
    [balance_v2.ino]
2026-08-14 Revert the launch-overdrive line of work; drive authority from lean instead
    Reverts 8d71d16, 4013030, 1e41b3b and 268a8f7. fa7b812 (stand-up recovery) is
    unrelated and kept. The FF block is now bit-for-bit 28badb1 -- verified by diffing
    every friction/ffBias/gate line against that commit.
    WHY. 28badb1 drove 1.79 revolutions (POS -0.625 -> 1.164). The four commits after
    it all chased "more aggressive launch" and each one traded a working robot for a
    new failure:
    268a8f7 FF boost -> oscillation returned
    1e41b3b one-way latch -> phases scrambled
    4013030 common floor -> one wheel turning (real fix, still bad)
    8d71d16 launch lean + lead -> deadlock, zero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
    [balance_v2.ino]
2026-08-14 Kill the ramp crawl, restore the common FF floor, boost only when stalled
    It drives now -- POS 0.252 -> -0.762, about 1.0 rev, and LEAN ACT genuinely
    reaches -17.0 deg before VELI collapses -9.00 -> -0.10 at MS 139875 as the
    breakaway detector fires. So the answer to "FF our launch sequence?" is no: the
    lean gets there on its own and does not need an opposite-direction launch push.
    Three narrower things were eating the time instead.
    1. THE RAMP DIED INTO A CRAWL. Measured 8.5 deg/s from MS 137170 to 138675, which
    matches the 8.8 design, so the law is right. But VEL_I_CLAMP 9 pinned the integral
    after 1.5 s and the last 2.4 deg then took 1.1 s at Kpos*Vmax = 2.4 deg/s -- over
    40% of the tota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
    [balance_v2.ino]
2026-08-14 Blend the FF floor on speed instead of gating it on wheelMoving
    The oscillation is a gate I added last commit, keying off a fast noisy variable --
    the same class of error that has produced most of the failures this session.
    Two consecutive telemetry samples:
    MS 17360 u = -10.13 FFB 0.98 DBL 15S DBR 27S -> floor 27+20=47 -> PWM +36
    MS 17460 u = -37.06 FFB 0.96 DBL 15S DBR 13M -> floor 15 -> PWM -22
    ffFloor dropped 47 -> 15 in one tick because wheelMoving flickered on the right.
    TWO things keyed off that flag -- the static/moving floor choice and the new
    ffBoostOk -- so they compounded into a 32-count step in the floor. wheelMoving
    toggles at encoder-noise level (DBR alte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
    [balance_v2.ino]
2026-08-14 Slew-limit the FF floor; the blend window was smaller than the encoder quantum
    Last commit replaced a discrete gate with a "continuous" blend and it changed
    nothing, because the blend was not actually continuous. Third instance of the same
    mistake this session, and worth recording plainly.
    ONE ENCODER COUNT IS 0.366 rev/s (546 cpr, x1 decode, 200 Hz). VRL/VRR step in
    +/-0.37 quanta throughout every log. FRICTION_FF_ROLL_VEL was 0.15, so the blend
    window was 2.4x SMALLER than the quantum: ffRoll still slammed 0->1 on a single
    count and ffFloor still stepped 13 <-> 47. Burst, with u essentially unchanged
    across the tick:
    i=72 u 1.834 PWM 10 i=145 u 16.139 PWM 1
    i=73 u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
    [balance_v2.ino]
2026-08-14 Turn the friction feedforward off; settled as not salvageable
    DRIVE_FRICTION_FF 1 -> 0.
    The two-phase feedforward cannot be made to work. LAUNCH and CRUISE push in
    OPPOSITE directions, so any gate between them turns a misclassification into a
    full-amplitude PWM reversal rather than a small error. Every gate was tried:
    3.0/1.5 hysteresis chattered on the pitch ring
    one-way latch caught a transient, could never recover
    -2.0 deg loss threshold released only on an INVERTED lean, not an absent one
    0.04 s rate lead fired correctly, body still overshot
    Final run: FFP alternating C,L,C,L,C,C,L,C,L,... on every 100 ms sample with FFB
    flipping +0.94, -1.00, +0.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
    [balance_v2.ino]
2026-08-14 Ramp the stiction floor in instead of stepping to it
    With the feedforward off the robot drives and reverses cleanly, and the remaining
    oscillation is down to one mechanism with a clear signature.
    Burst: u peaks at i = 21, 46, 70, 94, 117, 142, 168, 193, 219, 245, 271, 296 --
    intervals of 23-26 samples, so ~125 ms = 8 Hz, +/-9 on u and only about +/-0.5 deg
    on pitch. On every cycle PWM steps 0 -> -16/-28 and 0 -> +15/+27.
    That step is the sign-of-u floor, and with the FF gone it is the ONLY nonlinearity
    left in the loop. As a step it has INFINITE incremental gain exactly at the zero
    crossing, which is where the loop spends its time -- the textbook describing-
    function recipe for a limit cyc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
    [balance_v2.ino]
2026-08-14 Raise DRIVE_MAX_VEL 0.40 -> 0.60
    Requested from the v2-drive-works state. Single-constant change so the test reads
    cleanly.
    This is NOT only a speed cap. Both outer-loop ramp terms scale with it:
    lean ramp = (Kpos + KVEL_I) * Vmax = 30 * 0.60 = 18 deg/s, up from 12
    LEAN_CLAMP 18 now reached in ~1.0 s instead of ~1.5 s
    So expect it to lean into a command noticeably harder, not just run faster. That is
    the same coupling that made the ramp feel slow at 0.25.
    Encoder resolution improves as a side effect: one x1 count is 0.366 rev/s at 200 Hz,
    so the full-stick target was BELOW one count at 0.25, about 1.1 counts at 0.40, and
    about 1.6 at 0.60. The velocity loop finally regulates agai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
2026-08-14 Brake while coasting: keep the velocity integral alive after stick release
    The integral was zeroed the instant the stick centred, which dropped the
    outer loop's braking authority from LEAN_CLAMP 18 deg to Kpos*posError +
    Kvel*velError -- measured at 1.8 deg, below the ~6-7 deg breakaway lean.
    The robot therefore could not brake at all on release; it coasted on rolling
    friction. From the 2026-08-14 log, stick centred at 0.44 rev/s: 0.35 rev
    over 1.7 s, ending parked with a permanent 0.25 rev position error.
    Keep integrating while the wheels are still rolling, stick or no stick. With
    targetVel 0, velError = -forwardVel, so the counter-lean ramps at KVEL_I*|v|
    = 10.6 deg/s and clears breakaway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
    [balance_v2.ino]
2026-08-14 Raise DRIVE_MAX_VEL 0.60 -> 0.90
    Reported: too slow, too sluggish, cannot overcome minor bumps.
    This is the target-limited case, not the authority-limited one. In the 0.60
    drive log the loop was tracking its target rather than straining against a
    ceiling: TVEL 0.56 vs VF 0.55, VERR 0.01, and LEAN RAW peaked at 9.43 against
    a LEAN_CLAMP of 18 that never bound on forward acceleration. The robot
    delivered exactly the speed it was asked for, so the request was what was low
    -- raising LEAN_CLAMP would have changed nothing on flat ground.
    Ramp scales with it too: (Kpos + KVEL_I)*Vmax = 27 deg/s, up from 18, so the
    clamp is reachable in 0.67 s instead of 1.0. Bumps ride the same term -- a
    bump dr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
    [balance_v2.ino]
2026-08-14 Cap LEAN_CLAMP at 12: the chassis sits down at 15.7 deg of rear lean
    Manual tilt sweep, disarmed, measured on the bench:
    forward rest pitch +27.31 = LEAN ACT +30.53 (held 1.2 s)
    rear settle pitch -18.89 = LEAN ACT -15.67 (damped settle, steady)
    rear hard pitch -27.29 = LEAN ACT -24.07 (held 2.0 s)
    The chassis has 30.5 deg of forward lean and only 15.7 deg of rear lean
    before it rests on its rear contact. LEAN_CLAMP 18 commanded pitch -21.22,
    2.3 deg PAST that -- so every full-reverse command drove the robot onto its
    own backstop and parked there.
    Observed three times: LEAN RAW pinned at -18, encoders frozen 1.2-3.0 s,
    pitch held at -20.6..-21.5 (free rest -18.89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
    [balance_v2.ino]
2026-08-14 Split LEAN_CLAMP per direction (18 fwd / 12 rear) and widen the CH3 range
    Two independent changes, both revertible on their own.
    1. LEAN_CLAMP -> LEAN_CLAMP_FWD 18 / LEAN_CLAMP_REAR 12.
    The symmetric 12 fixed reverse by starving forward. Measured in the next
    drive log: LEAN RAW pinned at exactly 12.00 for 4+ s of held forward stick
    while VELI kept climbing (7.42 -> 7.63) and PERR stayed open at 0.55-0.73 --
    the loop asking for more lean than allowed, in the direction that has 30.5
    deg of physical room. A symmetric clamp must be sized for the worse side and
    the two sides differ by 2x.
    Forward 18 is not a guess: it is the value in every good forward-drive log,
    and forward has never exceeded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
    [balance_v2.ino]
2026-08-14 Correct the record: the forward clamp evidence was tether-contaminated
    The USB tether was fouling the right wheel in the log cited by a2cc1f9. That
    drag held forwardVel at 0.15 against a 0.51 target, and a permanently open
    velError is exactly what winds VELI into the clamp -- so "LEAN RAW pinned at
    12.00" is an artifact, not proof that clean-ground forward needs more than 12.
    The split stands on the geometry instead: the chassis is measurably asymmetric
    (30.53 fwd vs 15.67 rear), so one number must be sized for the worse side and
    is wrong-shaped for the better one; 18 forward is the value every good
    forward-drive log ran at rather than a new guess; and it costs nothing
    measurable, since for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
    [balance_v2.ino]
2026-08-14 Speed up the outer loop: LEAN_LPF 0.97 -> 0.95
    Reported: braking from forward takes too long to take effect and the bot
    crashes sometimes; backward-to-forward is much better.
    This addresses the lag half only. tau = DT/(1-alpha) goes 167 ms -> 100 ms.
    Measured cost at 0.97 on a full reversal: leanRaw hit the clamp in 400 ms,
    then leanCmd needed another 700 ms to follow (-13.42 -> -17.94 = 4.3 tau,
    matching the model to two decimals). At 0.95 that tail is ~410 ms.
    Held at 0.95 rather than lower because the outer-loop corner moves 0.95 ->
    1.6 Hz against an inner loop closing around 3-5 Hz, which is already only
    2-3x separation.
    The direction asymmetry is NOT fixed by this and cannot be in so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
    [balance_v2.ino]
2026-08-14 Size DRIVE_MAX_VEL by stopping distance: 0.90 -> 0.65
    Braking from forward was taking too long and crashing. Root cause is
    arithmetic I failed to run when raising the speed: stopping distance goes as
    v^2 / (g*tan(theta_rear)), and the last few commits moved both terms the
    wrong way at once.
    was: Vmax 0.60, rear 18 deg -> 3.19 m/s^2 (braked acceptably)
    then: Vmax 0.90, rear 12 deg -> 2.09 m/s^2
    ratio = (0.90/0.60)^2 * (3.19/2.09) = 3.4x the stopping distance
    The 12 deg rear cap is not negotiable -- the chassis sits down at 15.67 --
    so speed is the only remaining term. Reference points at that cap, relative
    to the config that stopped well: 0.49 = same distance, 0.60 = 1.5x,
    0.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
    [balance_v2.ino]
2026-08-14 Revert LEAN_LPF to 0.97: rear margin is scarcer than response time
    0.95 was never flown. Rear overshoot is the binding resource, not lag: pitch
    overshooting leanCmd is what consumes the 3.7 deg between LEAN_CLAMP_REAR 12
    and the -15.67 sit-down, and a faster command rotates the body faster into
    the lean, so it overshoots more.
    0.97 is also the only alpha where that overshoot is measured -- 2.78 deg
    peak on the rear side, MS 32705 of the good brake log. Going faster
    invalidated the one number the rear clamp is sized against, in the dangerous
    direction.
    Exchange rate is still unmeasured: slower leanCmd buys usable rear lean at
    roughly 8.5% deceleration per degree, which may beat the lag it c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
    [balance_v2.ino]
2026-08-14 Shape the velocity demand: rate-limit targetVel away from zero
    The loop had no concept of braking -- it only tracked a setpoint, so when
    momentum opposed the command all three outer terms saturated at once and
    stayed there. From a real forward->reverse slam (MS 31590): LEAN POS -3.24,
    VEL -4.37, VELI -10.86, RAW -18.47 -> clamped. The integral was doing 59% of
    the braking; a term meant to trim a cruise had become the primary brake
    authority, and it is the slowest thing in the loop. velError sat at -1.25
    rev/s for the whole maneuver so VELI wound at 30 deg/s and pinned in ~0.4 s.
    That makes the brake bang-bang rather than proportional (max lean from 0.4 s
    until the velocity crosses, equally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
    [balance_v2.ino]
2026-08-15 Give balance priority over turn in the mixer
    Turning is differential (effortL = u + turn, effortR = u - turn), so the
    fore-aft force -- the sum -- is exactly 2u and turn cancels out of the pitch
    axis. That is why turning has never upset the balancer. But the cancellation
    only holds while neither wheel saturates.
    When one wheel hits MAX_PWM the clip is one-sided: u + turn is truncated and
    u - turn is not, the sum stops being 2u, and the turn differential leaks into
    common mode -- a direct pitch disturbance arriving exactly when the loop has
    no authority left to reject it. Wheel RPM saturation does the same: past the
    motor's speed limit extra PWM buys no torque, so the outer wheel silently
    st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
    [balance_v2.ino]
2026-08-15 Widen FALL_REARM_DEG 8 -> 12 so a latched fall can be cleared
    Reported: "it disables and doesn't read commands at all until I physically
    push it". Two halves; this fixes the second.
    Once `fallen` latches, nothing re-arms until the ABSOLUTE accel angle is back
    inside FALL_REARM_DEG of the setpoint. At 8 deg the robot had to be held
    almost perfectly upright to clear it. 12 still requires a deliberate stand-up
    -- the rear sit-down is 15.67 and the forward stop 30.53, so a robot that is
    genuinely down reads far outside 12 and cannot self-clear by lying there.
    FINDING, not yet fixed: the safety angles were all sized against LEAN_CLAMP
    18 and Kp 2.0, and cutting the rear clamp to 12 invalidated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
    [balance_v2.ino]
2026-08-15 Restore LEAN_CLAMP_REAR to 18: the -15.67 sit-down was not real
    Second manual sweep, disarmed, back-to-front: rear rest is PITCH -28.5 =
    LEAN ACT -25.3, held steady a full second, and the chassis swept straight
    THROUGH -18.9 on the way up at 34-42 deg/s with no pause. Forward agrees
    across both sweeps (+30.53 / +29.97), which is what made the rear
    disagreement easy to miss.
    The -15.67 I sized the rear clamp against was a dynamic settle in the earlier
    sweep -- wherever the torques happened to balance on that particular release
    -- taken during the period when the tether was fouling the right wheel. Not a
    hard contact. Everything built on it (dc2d3fe, and the DRIVE_MAX_VEL cut in
    0d95dee that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
2026-08-15 LEAN_CLAMP_REAR 18 -> 14: keep the command off the soft rear contact
    Stand-up is fixed but reverse stalls again, exactly as it did at 18 before.
    Reconciling the two sweeps: there are TWO rear contacts, and each sweep found
    a different one. A soft/compliant one around -19 to -21 (the first sweep
    settled at -18.89; the second swept through at 34-42 deg/s without pausing,
    which is what a compliant contact does to a fast hand sweep) and a hard rest
    at -25.3. So the earlier -15.67 was not pure artifact after all -- it was a
    real contact, just not the hard limit I sized against.
    At clamp 18 the commanded pitch is -21.22, inside the soft band, and every
    logged reverse stall parked at -20.6..-21.5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
    [balance_v2.ino]
2026-08-15 FLOOR_KNEE 5.0 -> 2.5: the rear stall is a breakaway dead zone, not a contact
    Clean tether-free reverse log settles it: the stall angle FOLLOWS THE COMMAND.
    Clamp 18 parked at pitch -20.6; clamp 14 parks at -17.2. There is no fixed
    rear obstacle -- the loop reaches whatever lean is asked for and then never
    breaks away. That retires the backstop theory chased across dc2d3fe,
    b4f5e3b and 7497034.
    Mechanism: pwm = deadband*(|u|/FLOOR_KNEE) + |u|, so at FLOOR_KNEE 5 the right
    wheel needs |u| >= 3.7 to reach its own 27-count static floor. Once pitch
    reaches target, ERR ~ 0 and |u| oscillates 0.15..3.7, flipping sign every tick
    or two. Peak PWM measured 23 against a breakaway of 27 -- never once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
    [balance_v2.ino]
2026-08-15 Enable DEADBAND_TEST to measure the 27-vs-15 breakaway asymmetry
    The right wheel's 27-count static floor against the left's 15 is the root of
    the rear stall (see FLOOR_KNEE), and it has never been measured directly.
    Run at MOTOR_PWM_HZ 4482, 2000, 1200 and fit
    deadband = t_on * f_pwm * 256 + mechanical
    Predicted driver-delay term at t_on ~8 us: 9.2 / 4.1 / 2.5 counts. If the
    floors fall by about that much, the gap is BTS7960 turn-on delay and a lower
    PWM frequency shrinks both; if they barely move it is real friction.
    Note the test ramps POSITIVE PWM only, which on this wiring is physical
    backward -- the same direction that stalls, so this measures exactly the case
    of interest.
    Must b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
    [balance_v2.ino]
2026-08-15 Deadband sweep: MOTOR_PWM_HZ 4482 -> 2000 for the second data point
    Free-spin breakaway at 4482 measured L@13 R@12, and L@14 R@13 on a repeat, so
    repeatability is +/-1 count.
    Two things that reads on already:
    - the 15/27 asymmetry in the config is NOT the motors or drivers. Off the
    ground both wheels break at the same PWM, so 15/27 is purely LOAD.
    - the predicted BTS7960 turn-on delay term at 4482 Hz is 9.2 counts against
    a measured free-spin floor of ~12.5, leaving ~3 for unloaded mechanical.
    About 75% of the floor is driver delay.
    If that holds, 1200 Hz should drop the free-spin floor to ~5-6 and take ~6.7
    counts off both loaded floors (15/27 -> ~8/20), which would attack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
2026-08-15 Deadband sweep: 1200 Hz, third point. Two-point fit revises t_on down
    Free-spin breakaway, wheels off the ground:
    4482 Hz L@13 R@12 (repeat L@14 R@13, so +/-1 count)
    2000 Hz L@11 R@9
    Two-point fit with dt = 1/(f*256), i.e. 0.872 us and 1.953 us per count:
    L: 2.5 counts of drop -> t_on ~3.9 us, mechanical ~9.0
    R: 3.5 counts of drop -> t_on ~5.5 us, mechanical ~6.2
    Turn-on delay is 4-5.5 us, not the ~8 us assumed from the datasheet figures,
    and the unloaded mechanical floor is 6-9 counts rather than ~3. So the driver
    term is smaller than predicted and mostly spent by 2000 Hz.
    Extrapolating to 1200 Hz (dt 3.26 us) predicts only L@10 R@8 -- about one more
    count. This third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
2026-08-15 Record the deadband sweep results and the left-channel anomaly
    L R
    4482 13 12 (repeat 14 / 13, so +/-1 count)
    2000 11 9
    1200 21 8
    R is a clean monotonic fit and 1200 landed exactly on the predicted 8. L is
    not monotonic -- a floor cannot rise as frequency falls -- so L@21 is a bad
    sample rather than a measurement.
    Blocking: at 1200 the log shows dL -14 (barely moved) and dR -358 (spun
    freely), but the pilot observed the RIGHT wheel barely moving. If the encoder
    channels are mislabelled, every left/right constant in this file is on the
    wrong wheel. Deadbands must not be tuned until that is resolved.
    Surviving conclusions:
    - the 15/27 loaded asymmetry is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
    [balance_v2.ino]
2026-08-15 Adopt 2000 Hz from the sweep and rescale the deadbands; test off
    Sweep, free-spin breakaway, wheels off the ground:
    1200 21 8 <- L reproduced twice, dL -25 vs dR -360
    1200 is rejected: a floor cannot RISE as frequency falls, so L@21 is not the
    turn-on-delay model, it is the left channel misbehaving at 1200. The boot
    banner shows L on ONE FlexPWM submodule (2_2 A/B, pins 6/9) and R on TWO
    (4_0A / 4_1A, pins 22/23), which fits a left-only frequency-dependent fault.
    Do not go below 2000 without re-checking that channel.
    2000 is the best measured point: both floors below 4482 and no anomaly.
    Deadbands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
2026-08-15 Let DEADBAND_TEST ramp either direction
    The mirroring itself is correct and settled -- motors mirrored in the wiring,
    encoders in code via ENC_*_DIR -- but it is adjacent to something never
    measured.
    motorRaw(+) is physical BACKWARD, and the test only ever ramped positive, so
    every deadband figure in this file is a reverse-direction number. Forward has
    never been measured. Meanwhile mapEffortToPwm applies ONE constant per wheel
    to both signs:
    pwm = deadband * ramp + fabs(effort);
    return effort > 0 ? pwm : -pwm;
    so if breakaway differs by direction (backlash, gearbox preload -- the
    existing caveat comment says the turn logs already hint at it) one direction
    is mis-compensated and t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
    [balance_v2.ino]
2026-08-15 EN wiring fault found: the 13/24 deadband asymmetry was never in the machine
    One bridge had bad EN wiring. It braked at idle while the other coasted, and that
    one fault plus a habit of setting constants from single ramps produced most of the
    deadband lore in this file. Fixed in hardware by the pilot; this commit re-measures
    everything that depended on it and retracts what it invalidates.
    DEADBAND_TEST is now multi-pass: DEADBAND_TEST_PASSES ramps back to back, sign
    alternating each pass, coast-down between, summary table at the end. Repeats because
    repeatability turned out to BE the measurement; interleaved rather than blocked so
    direction is not confounded with session drift (warming, batt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
    [balance_v2.ino]
2026-08-15 Loaded re-run confirms 18/18, but the left-channel dropout survived the EN fix
    Second loaded 6-pass run, this time with the deadbandDetect twitch fix in place:
    back(+1) L 33, 18, 17 R 18, 17, 19
    fwd (-1) L 16, 20, 16 R 17, 21, 17
    Discarding the pass-1 L@33, L reads 16,18,20,17,16 and R reads 17,17,18,19,21,17 --
    both median 17-18 across two independent loaded runs. 18/18 stands, unchanged.
    RETRACTS the claim in 9741e6c that the EN repair closed ac0b305's left-channel
    anomaly. Pass 1 here: dL EXACTLY 0 for 32 consecutive steps while dR broke at 18 and
    reached -496, L finally moving at 33. That is the same signature as every historical
    event -- left stuck, right spinning freel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
    [balance_v2.ino]
2026-08-15 The left-channel dropout is the USB tether, and it inflates the loaded numbers too
    Third loaded 6-pass run, better tether:
    back(+1) L 17, 15, 16 R 20, 16, 17
    fwd (-1) L 27, 18, 16 R 16, 19, 16
    The dropout moved to PASS 2 this time (dL exactly 0 from PWM 0 through 26, then 37 at
    27, while dR reached 207), which kills the "always the first ramp after power-up"
    pattern from 9dadfac.
    It is a known rig artefact, recorded 2026-06-30: the USB tether drags the LEFT wheel,
    and it was misread as a friction asymmetry that time too. It accounts for every
    feature at once -- always the left, EXACTLY zero counts rather than a noisy channel,
    intermittent, and clearing once the ramp can drag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
2026-08-15 Fourth loaded run: 18/18 confirmed on ~45 samples; retract the tether-inflation trend
    Run 4, loaded, clean -- no dropout in any pass, dL jittering normally throughout,
    which is what the tether diagnosis predicts (discrete snags, absent when the cable
    falls well):
    back(+1) L 19, 14, 17 R 20, 16, 17
    fwd (-1) L 19, 17, 19 R 19, 19, 20
    RETRACTS the ~2-count tether bias claimed in 16272f6. Per-run medians read L 18/17/16
    and R 18.5/17.5/16.5 across three runs, which looked monotonic; run 4 on the same
    tether came back L 18 / R 19. Three points were not a trend. The tether causes snags,
    not a baseline shift. Reading a trend out of three samples is the precise error this
    whole thre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
    [balance_v2.ino]
2026-08-15 The no-FF path was still selecting its floor from a gate that chatters every tick
    Symptom from the 2026-08-15 flight: balancing is good, but small throttle never breaks
    away -- the robot leans further and further and only rolls at about half stick.
    The burst says why. u peaks at i = 14, 37, 59, 83, 106, 128, 151, 175, 199 -- intervals
    of 22-24 samples at 200 Hz, so ~8.7 Hz -- with |u| 4-6 turning into PWM alternating
    +21/-25 and crossing zero every ~5 samples. Each half-cycle is ~57 ms of one-directional
    drive, which is not long enough to break a wheel free, so it dithers in place: DL/DR
    stay at 0-4 counts while LEAN CMD winds up to 12-16 deg. The robot only moves once that
    DC lean finally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
2026-08-15 The chattering-floor fix killed the 8 Hz cycle; FLOOR_KNEE 2.5 -> 1.0 for breakaway
    d17f3e2 worked. Flight telemetry: DBF slews 18.0 -> 17.9 -> ... -> 13.9 -> 14.1
    continuously and never steps, while MV still chatters SS/MM/MS/SM with nothing reading
    it. The burst is a different machine:
    before PWM +21/-25, zero crossing every ~5 samples, |u| 4-6, RATE +/-25..30
    after PWM 0..14 holding one sign for tens of samples, |u| ~1.5, RATE +/-3
    The 22-24 sample periodicity is gone entirely. The 8 Hz limit cycle was the chattering
    static/moving gate, not the zero-crossing gain.
    Which makes the ramp that was defending against it pure loss, and it is what blocks
    breakaway. Same flight: 5.7 s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
    [balance_v2.ino]
2026-08-15 Revert FLOOR_KNEE to 2.5: 1.0 was worse, and the reverse stall is the rear contact
    FLOOR_KNEE 1.0 reinstated the limit cycle BIGGER and did not fix breakaway. Burst:
    * u peaks every ~27 samples at 200 Hz = 7.4 Hz, |u| up to 10 (was ~1.5 at KNEE 2.5)
    * PWM slams 0 -> +/-18..28, zero crossing every ~10-13 samples. The ramp saturates by
    |u| = 1.0, so the map is a near-relay: B133 u -0.61 -> -11, B134 u 0.78 -> +14,
    B135 u 2.40 -> +19. Incremental gain 18.9, exactly the risk named in e3038ae.
    * ENC deltas still 0-3 counts. The wheel gets +20 for ~65 ms then -20 for ~65 ms and
    nets zero -- the original failure with a louder amplitude.
    INVALIDATES the reasoning behind e3038ae. W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
    [balance_v2.ino]
2026-08-15 Throttle: raise top speed, raise the lower bound, and slow the turns
    Pilot request: more rpm, narrower rpm range on the throttle with the lower bound raised,
    and turns are still faster than the drive.
    DRIVE_MAX_VEL 0.65 -> 1.00. The old "conservative on purpose" note was about encoder
    resolution, and resolution improves as speed rises -- one count per 5 ms tick is 0.366
    rev/s, so 0.65 was ~1.8 counts/tick and 1.00 is ~2.7. That argument constrains the LOW
    end, not the top. The machine already showed the headroom: VF hit 0.86 on the 2026-08-15
    flight while the target was capped at 0.65.
    DRIVE_MIN_VEL 0.30, new. The stick used to scale linearly from zero, so just past the
    deadzone it asked f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
2026-08-15 LEAN_CLAMP_FWD 18 -> 24: the forward cap was truncating against unused travel
    Pilot: "can't break away, the requested lean is probably out of bound of achievable or
    clamped, because there is still space to the ground." The log agrees:
    LEAN RAW 18.00 CMD 18.00 held for seconds at a time
    TARGET 14.78 = BALANCE_SETPOINT -3.22 + 18.00
    forward stop +30.53 -> 15.75 deg of forward travel never used
    RAW equalling CMD exactly is the tell: the outer loop was asking for more lean than the
    clamp allows and getting truncated, with half the forward range spare. Raising
    DRIVE_MAX_VEL 0.65 -> 1.00 in ae7a7f7 made it worse -- more velocity demand, more lean
    demand, same ceiling.
    2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
2026-08-15 LEAN_CLAMP_REAR 14 -> 16, and flag that the rear contact angle is unmeasured
    Pilot reports the same truncation and jitter in reverse as forward, and the log shows it:
    LEAN RAW -14.00 = CMD -14.00, pinned, request being cut off.
    Raised 2 deg rather than the 6 that LEAN_CLAMP_FWD got, because the two budgets are not
    comparable. BALANCE_SETPOINT -3.22 subtracts from forward reach and adds to rear reach, so
    the same clamp number is worth 3.2 deg less one way and 3.2 more the other:
    fwd 24 -> TARGET +20.78 against +30.53 = 9.7 deg margin
    rear 14 -> TARGET -17.22 against ~-19 = 1.8 deg margin
    16 puts the rear TARGET at -19.2, essentially on the documented soft contact.
    THE CONTACT F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
    [balance_v2.ino]
2026-08-15 LEAN_CLAMP_REAR 16 -> 14: the rear backstop is -21.0, measured
    Reverting my own +2 from 2878e41. That change was arithmetic on a contact angle nobody
    had measured; this flight measured it. Disarmed, motors off (PWML 0 PWMR 0), the chassis
    settles at PITCH -21.0 +/- 0.15 and holds it for a full second at RATE ~0 -- ten
    consecutive samples, MS 20340..21340. All three figures previously in circulation were
    wrong: this file's "~-19 soft contact", the 2026-06 note's "-15.7", and my 16.
    At 16 the rear TARGET is -19.22 and PITCH peaked -20.14, 0.9 deg off the stop, i.e.
    touching down. Free-body arithmetic on the same window agrees: sustained PITCH -19.2 with
    VF 0.02 and POS moving 0.169 -> 0.163,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
    [balance_v2.ino]
2026-08-15 Revert the lean-clamp excursion and the throttle widening; keep the actual request
    Pilot: "Why are we changing lean? It worked some time ago. we wanted to clamp a lower
    bound of throttle." Correct on both counts.
    The request was: more rpm, REDUCE the range, "not lean range, but rpm range", increase the
    lower bound. Raising DRIVE_MAX_VEL 0.65 -> 1.00 widened the range instead of reducing it,
    and that is the root of everything since. A 1.00 rev/s demand makes velError large enough
    to pin the outer loop against LEAN_CLAMP_FWD, which in telemetry is indistinguishable from
    a forward clamp set too low -- so I read it as one and went after the lean geometry for
    three commits. The clamp was only bi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
    [balance_v2.ino]
2026-08-15 Downgrade the -21.0 rear figure from "measured limit" to "release settle"
    Correcting the previous two commit messages and the comments they added. I called PITCH
    -21.0 a measured backstop. It is not: it came from letting the disarmed chassis settle,
    which is precisely the class of measurement that produced the bogus -15.67 rear limit and
    cost most of a session. A rest angle reached by RELEASING is wherever the torques happened
    to balance on that release. It can equally be the tether, which has now caused four wrong
    conclusions on this robot.
    A real limit is where the chassis stops under a slow deliberate push and reproduces across
    sweeps. The standing two-sweep manual measurement puts the r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
    [balance_v2.ino]
2026-08-15 Lean clamps 24 fwd / 18 rear: stop sizing to numbers that never reproduced
    Pilot, twice: "why do we reduce the angles again? we measure forward angle near 32 degrees
    and a rear 20+ degrees", and "no, rear has range. it won't break away again, if we keep
    reduced." Both correct.
    LEAN_CLAMP_FWD 18 -> 24 TARGET +20.78 vs a measured stop near +32
    LEAN_CLAMP_REAR 14 -> 18 TARGET -21.22 vs rear rest -28.5 (two-sweep) / pilot's 20+
    I had cut the rear to 14 against a PITCH -21.0 "backstop" taken from a disarmed RELEASE
    settle. That is not a limit -- it is the same class of measurement as the -15.67 sit-down
    this file already documents as bogus, and sizing to it re-created the reverse-break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
    [balance_v2.ino]
2026-08-15 Rebuild the friction feedforward single-signed and switch it on
    Pilot: "it doesn't matter what you put as a clamped angles if the bot can't break away.
    and reach the requested angle." Correct, and the log agrees that the angle is not the
    missing half: at the rear pin LEAN ACT holds -13.5..-14.9 against LEAN CMD -14.00 for
    seconds, so the requested lean IS reached and tracked, while POS moves 0.005 -> 0.000.
    The lean works. The translation does not. Clamps cannot fix that, and I spent four commits
    on them.
    Cause, which this file had already converged on: the friction floor is applied with the
    sign of the INSTANTANEOUS u. With DBF 17 and u dithering +/-6 at 8 Hz, PWM swings +/-20..25
    -- about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
    [balance_v2.ino]
2026-08-15 Revert "Rebuild the friction feedforward single-signed and switch it on"
    This reverts commit 2a054348715bfb77774faab04f55efdde377d05a.
    [balance_v2.ino]
2026-08-15 Record why the single-signed feedforward failed: velError is wrong at all times
    Documents the revert in 1d7de41 so this is not attempted a third time.
    I built exactly the single-signed feedforward the note asked for -- LAUNCH and the lean
    gate deleted from the source, one phase, nothing to misclassify -- and it failed harder
    than the two-phase version. Single-signed is necessary but not sufficient.
    The flight, with ffFloor ~38:
    PITCH 8.47 TARGET 20.78 ERR -12.31 U 49.43 FFB -1.00 PWML 11
    cmd = 38 * (-1.00) + 49.43 = 11
    The bias ate 38 of the PD's 49 for seconds. LEAN ACT froze at 11.7 while LEAN CMD ran to
    24.00, ERR pinned at -12.3, encoders dead at L -15 R -19, POS -0.031 un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
    [balance_v2.ino]
2026-08-15 FLOOR_KNEE 2.5 -> 5.0, the value in tag v2-drive-works
    Found by diffing the working tag instead of reasoning from another log. Pilot: "compare
    the working tag with what we have... we are going in circles now." Right, and the diff
    shows why: twelve functional changes have accumulated since a20285b (v2-drive-works), and
    FLOOR_KNEE is one I thought I had already reverted and had not.
    The history: 2.5 -> 1.0 was flown ("made it worse. To jittery, can't break away") and then
    "reverted" -- but the revert landed on 2.5, not on the 5.0 that the working build used. So
    the knee has been below its known-good value all session while I hunted the jitter in lean
    clamps, gains and the feedforward.
    It is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
    [balance_v2.ino]
2026-08-15 Reset balance_v2.ino to v2-drive-works; record the salvage list
    We hit a wall: the robot leans correctly but will not translate at any throttle value, and
    33 commits of tuning on this branch have not moved that. Pilot: "we faced a wall. revert to
    a working tag and note usefull patches we may apply."
    balance_v2/balance_v2.ino is now byte-identical to tag v2-drive-works (a20285b), the last
    build where drive actually worked. Nothing is lost -- the branch history is intact and every
    patch is recoverable by SHA.
    PATCHES_FROM_CASCADE.md records what is worth taking, in tiers, with the evidence for each:
    Tier 1, apply -- hardware truth or a real defect:
    deadbands 11/13,15/27 -> 10/10,18/18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
    [balance_v2.ino]
2026-08-15 Apply Tier 1 + Tier 3 from the salvage list onto v2-drive-works
    Four patches, all carried forward from the cascade branch onto the working tag. Nothing
    else changed -- the functional diff against v2-drive-works is exactly these.
    1.1 Deadbands 11/13, 15/27 -> 10/10, 18/18.
    The tag's numbers were measured while one BTS7960 had an ENABLE-PIN WIRING FAULT: one
    bridge braked at idle while the other coasted, so the "stiffer" wheel was being
    electrically braked, not mechanically dragged. The pilot's observation is what settles
    it -- the right wheel was tighter ONLY WHEN POWERED; with the robot off both spun the
    same. The wiring is repaired; re-measured over four loaded runs and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
    [balance_v2.ino]
2026-08-17 Add LEAN_SWEEP: measure lean limits the way this file says limits must be measured
    Wheels went 120 -> 140 mm, so every angle in this file is stale and the rear figure was
    never trustworthy to begin with -- "measured" three times as -19, -15.7 and -21.0, with
    firmware sized to each in turn. All three were read off a scrolling stream by eye or taken
    from a RELEASE settle, which is where the chassis lands when you let go, not where it stops.
    LEAN_SWEEP is the instrument for the rule already written at LEAN_CLAMP_REAR: a limit is
    where the chassis stops under a SLOW DELIBERATE PUSH and REPRODUCES ACROSS SWEEPS. Motors
    off throughout. It refuses to report an angle until the body has held still
    (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
2026-08-17 Enable LEAN_SWEEP for the 140 mm angle measurement
    Flag flipped to 1 so the next flash runs the lean-limit sweep. Motors stay off for the
    whole mode, so this cannot drive the robot.
    SET IT BACK TO 0 BEFORE FLYING -- with LEAN_SWEEP 1 the balance loop never runs.
    [balance_v2.ino]
2026-08-17 Record measured 140 mm lean limits; fix the peak-vs-rest warning
    LEAN_SWEEP first run. Pilot confirmed the stops by feel: "hard stop - solid bot frame".
    forward +55.0 .. +55.3 clean -- four samples at |rate| 0.2-2.4, spread ~0.3
    rear -50.1 .. -54.6 messy -- bounced ~3.3 deg for two seconds; call it -52 +/- 2
    and re-measure before sizing to it
    Against the pre-140 mm figures of ~+30 / -25, the extra 10 mm of axle height did not so much
    widen the range as remove whatever was catching. The rear number needs another pass; the
    direction of the result does not.
    THE CONSEQUENCE IS THE POINT: geometry is now the LOOSEST constraint on lean, not the
    tig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
    [balance_v2.ino]
2026-08-17 Second sweep: forward stop is +61, rear ~-51; stop calling n=1 "usable"
    Two sweeps now, pilot confirming the stops by feel.
    forward +61.0 run 2 held 60.6..61.6 across ~17 samples at |rate| 0.0-2.0
    rear ~-51 run 1 -50.1..-53.4, run 2 -49.4..-51.7, overlap -50..-51.7
    The forward runs looked like a 5.6 deg disagreement and were not. Run 1 held at 49.7 (which
    fired a REST), pushed on to 55.3, and released -- both were under-pushes that never reached
    the frame. Run 2 arrived and sat there. Recorded in the source as a caution: when a repeat
    "disagrees", check whether the earlier sweep ever got to the stop before calling it spread.
    FIXED, and it is the more important half of th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
    [balance_v2.ino]
2026-08-17 Saturation latch: require a hopeless ANGLE as well as a pinned output
    The latch tested effort alone, and effort is not an angle. |u| ~ Kpeff * |error|, and Kpeff
    doubles from 2.0 to 4.0 under the drive gain schedule, so the threshold
    SAT_EFFORT_FRAC * (MAX_PWM - MAX_DEADBAND) = 87.4 meant two different things:
    Kpeff 2.0 (balancing) -> 87.4 / 2.0 = 43.7 deg
    Kpeff 4.0 (driving) -> 87.4 / 4.0 = 21.9 deg
    A 2x swing in a safety threshold, set by a gain schedule that has nothing to do with safety,
    with the tighter half landing while DRIVING -- which is exactly when large transient tracking
    errors happen. Meanwhile the comment at FALL_CUTOFF_DEG reasons about this latch as a fixed
    "abov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
    [balance_v2.ino]
2026-08-17 MAX_PWM 110 -> 140 to give back the force the bigger wheels took
    Ground force is torque/R, so going 120 -> 140 mm cut the force available at any given PWM by
    1/1.167. Leaving the ceiling at 110 therefore quietly reduced peak accelerating force by 14%
    against the build these gains were tuned on. 128 would restore parity; 140 restores it and
    adds ~9% of real headroom. Still only 55% of the 255 range.
    What it buys: the TOP end -- recovery from large angles, peak acceleration.
    What it does NOT buy: breakaway. That happens at small commanded effort where PWM is
    plainFloor*ramp + |u| and the floor dominates; the ceiling does not appear in that
    expression. Peak PWM across every log this session wa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
2026-08-17 Rear lean clamp 18 -> 10: stop commanding the robot onto its own equilibrium
    LEAN_SWEEP found a STABLE EQUILIBRIUM AT PITCH -18.2 -- motors off, 23 consecutive samples
    between -18.09 and -18.34 at |rate| 0.0-0.4, spread 0.25. The pilot had already named the
    mechanism before the measurement: the chassis has distinct points of balance, and "when the
    lean is similar to those points it can't move".
    THAT IS THE STALL, and it has been the stall all session. Gravity torque about the contact
    patch is zero at an equilibrium, so a commanded lean placed there has no drive authority by
    construction. The loop reaches the target, ERR -> 0, u -> 0, PWM -> 0, and the robot sits.
    It was never failing to tra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
    [balance_v2.ino]
2026-08-17 LEAN_SWEEP back to 0: flight build
    Angle measurement is done. All test modes now off (ENCODER_TEST, DEADBAND_TEST,
    STATIC_LEAN_TEST, IMU_TEST, LEAN_SWEEP), so the balance loop runs.
    Flight config in this build:
    MOTOR_PWM_HZ 2000 with the deadbands measured at that frequency
    deadbands 10/10 moving, 18/18 static (post-EN-fix; still 120 mm figures)
    FLOOR_KNEE 5.0 tag value, zero-crossing gain 4.6
    MAX_PWM 140 gives back the force the 140 mm wheels took, +9%
    LEAN_CLAMP_FWD 18 TARGET +14.78
    LEAN_CLAMP_REAR 10 TARGET -13.22, 5 deg short of the -18.2 equilibrium
    SAT_TRIP_DEG 39 latch now needs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
    [balance_v2.ino]
2026-08-17 Release the lean: both clamps to 40, pilot decides what is usable
    Pilot: "release all lean. Doesn't matter if it's usable or not. I should be controlled by
    the pilot." So the firmware stops fencing off the parts of the range it judged unproductive.
    18 fwd / 10 rear -> 40 / 40.
    40 is the largest value that is not self-defeating. FALL_CUTOFF_DEG tests
    fabs(pitch - BALANCE_SETPOINT) -- the LEAN from the balance point, not absolute pitch -- so
    it is a direct ceiling on this constant. A clamp of 45 would command exactly the angle that
    latches the robot as fallen, i.e. full stick would cut the motors. 40 leaves 5 deg for
    tracking overshoot.
    RECOVERY_GIVEUP_DEG 32 does not bind: it gates on track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
    [balance_v2.ino]
2026-08-17 Move the fall latch to the frame; fix RECOVERY_GIVEUP gating on lean instead of error
    Pilot: "the hard ceiling should be the rest degree. when the bot leans on the frame" and
    "we shouldn't overconstrain it."
    FALL_CUTOFF was a single symmetric 45 deg of lean, which gave up while the robot was still
    on its wheels with travel in hand. Split and moved to the measured frame contacts:
    rear PITCH -51 -> lean -47.8 -> FALL_CUTOFF_REAR_DEG 47
    forward PITCH +61 -> lean +64.2 -> FALL_CUTOFF_FWD_DEG 63
    Asymmetric because the chassis is, and because BALANCE_SETPOINT -3.22 shifts the directions
    oppositely; one symmetric number would have to take the rear value and throw away 17 deg of
    forwa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
    [balance_v2.ino]
2026-08-17 VEL_I_CLAMP 14 -> 24: the constant that was actually limiting lean
    Raising LEAN_CLAMP to 60/44 to "release the lean" was inert. The outer loop's three terms
    are separately capped and their sum, not LEAN_CLAMP, was the ceiling:
    Kpos * POS_ERROR_CLAMP = 6.0 * 1.5 = 9.0
    Kveff * velError ~ 1.2
    VEL_I_CLAMP = 14.0 <- dominant
    ------
    24.2 deg reachable, logs topped out at RAW 18.95
    So no LEAN_CLAMP above ~24 could bind. At VEL_I_CLAMP 24 the sum is ~34 deg of reachable
    lean, which clears the rear torque null at lean -14.98 with real room beyond it -- the point
    of r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
2026-08-17 Throttle: DRIVE_MAX_VEL 0.65, DRIVE_MIN_VEL 0.30, TURN_AUTHORITY 16
    Three constants the pilot had already asked for, put in together rather than dripped across
    three flights. All were lost in the reset to v2-drive-works (Tier 2 of the salvage list).
    DRIVE_MAX_VEL 0.40 -> 0.65. The resolution argument in the old comment runs the wrong way
    and should not have held this down: one encoder count per 5 ms tick is 0.366 rev/s, so
    0.40 rev/s is 1.1 counts/tick and 0.65 is 1.8. Going faster IMPROVES the velocity estimate;
    standing still is what starves it. The real constraint is stopping distance, and 0.65 is
    what that analysis produced (0.90 -> 0.65) and what was flying before the reset. With 140 m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
    [balance_v2.ino]
2026-08-17 LEAN_LPF 0.97 -> 0.95: halve the outer-loop lag now that rear margin is not scarce
    tau = -DT/ln(a), so 164 ms -> 98 ms on the leanCmd EMA.
    This value flew once before and was reverted with "rear margin is scarcer than response
    time". That reason has expired. Rear margin was scarce when the fall latch was a symmetric
    45 deg of lean and the frame angle was unknown -- and the figures then in circulation for it
    (-19, -15.7, -21.0) were all wrong. The frame is now measured at lean -47.8, the latch sits
    at 47, and reachable lean is ~34 deg (VEL_I_CLAMP 24). There is roughly 13 deg of unused rear
    travel, so buying response time with a little of it is no longer the trade it was.
    Pure lag reduction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
    [balance_v2.ino]
2026-08-19 Add EMF_TEST: measure the back-EMF feedforward gain K_EMF
    Pilot: "bot may escape the commanded lean when it reaches higher velocity. Is there a
    solution without clamping the rpm?"
    There is, and this measures the constant it needs. Nothing in the control path supplies the
    voltage a motor needs just to HOLD a speed against its own back-EMF. The only thing writing
    PWM is the inner PD, which produces output from PITCH ERROR -- so at cruise the loop has to
    manufacture the speed-holding voltage out of a standing pitch offset, and that offset grows
    with speed. That is exactly "escapes the commanded lean at higher velocity": PITCH walks away
    from TARGET as VF rises and ERR never returns to zero. Wi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
    [balance_v2.ino]
2026-08-19 Fix build: EMF_TEST functions were nested inside leanSweepLoop
    Compile error:
    error: a function-definition is not allowed here before '{' token
    error: 'emfTestLoop' was not declared in this scope
    Self-inflicted and worth recording. I inserted the two functions by line number, but an
    earlier insert in the same session had already shifted the file by six lines, so the block
    landed six lines short of leanSweepLoop's closing brace -- i.e. in the middle of it. C++ has
    no nested function definitions, hence both errors, and the third followed because emfTestLoop
    was never visible at file scope.
    Moved the block to after leanSweepLoop actually ends. Verified structurally rather than by
    eye: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
    [balance_v2.ino]
2026-08-19 Wire in the back-EMF feedforward at 80% of the measured gain
    EMF_TEST free-spin staircase, 14 steps from PWM 10 to 140:
    LEFT K_EMF 43.6 PWM per rev/s, intercept 4.1, n 13
    RIGHT K_EMF 45.1 PWM per rev/s, intercept 5.1, n 14
    Per-step slopes held 42-47 across the whole range, so the linear model is right rather than
    merely fitted.
    The intercept landing at 4-5 instead of at the MOVING deadband of 10 is expected, and is
    itself a check on the model: 10 is the BREAKAWAY threshold of a STOPPED wheel, while this
    line describes a wheel already turning, and kinetic friction sits below stiction. A fit that
    had come back at 10 would have been the surprising one.
    Applied as pwmL/R += EMF_FF_S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
2026-08-19 Revert the lean release; scale turn by throttle
    REVERT, on evidence rather than taste. The last flight proved the lean direction is
    exhausted: both outer-loop terms saturated and the robot still would not move.
    LEAN ACT -35.63 POS -9.00 (= Kpos*POS_ERROR_CLAMP, capped) VELI -24.00 (capped)
    RAW -34.91 CMD -34.91 with LEAN_CLAMP_REAR 44 NOT binding
    PITCH -38.85 TARGET -38.13 ERR -0.72 U 3.09 PWML 14 VF -0.01 DL 0
    35 deg of lean does not break the wheels loose, so more lean cannot help. The reason is one
    line: ERR is 0.72, so U is 3.09, so PWM is 14 -- BELOW the ~18 static breakaway. The inner
    loop has arrived at its target and has no reason to push harder, and MAX_PWM 14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
    [balance_v2.ino]
2026-08-19 Stall-breakaway assist: PWM from unmet velocity demand, gated on the PD being idle
    EXPERIMENT. Sits on top of tag v2-lean-baseline, which is the fallback.
    The last flight proved lean is exhausted: both outer-loop terms saturated at LEAN ACT -35.6
    and the robot did not move, because ERR 0.72 -> U 3.09 -> PWM 14, under the ~18 static floor.
    The inner loop had ARRIVED and had no reason to push. Lean is not a torque command; when
    stiction is the blocker only wheel torque helps. So this drives PWM from UNMET VELOCITY
    DEMAND rather than from pitch error.
    This idea has failed twice and both failures are addressed by construction:
    1. The two-phase feedforward needed a gate between opposing phas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
    [balance_v2.ino]
2026-08-19 Breakaway assist becomes a one-sided output floor; ceiling 26 -> 30
    The assist behaved exactly as designed and still did not move the robot. It ramped
    2->6->10->17->22->26, held, kept a consistent sign, and collapsed to 0 within two ticks of
    the wheels rolling (SBA -6 -> -2 -> 0 as VF reached -0.33). No chatter, no runaway. The
    mechanism is sound; it was under-powered.
    Why, from the log:
    PITCH -20.50 TARGET -21.22 ERR 0.72 U -2.77 SBA 26 -> PWML 14
    u -2.77 through the floor map = 17.8*(2.77/5) + 2.77 = 12, signed negative -> -12
    -12 + 26 = 14, still under the ~18 static floor
    THE PD WAS SUBTRACTING 12 OF THE 26. It opposes because the robot is 0.72 deg SHORT of a
    rearward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
    [balance_v2.ino]
2026-08-19 Remove the lean clamp entirely
    Pilot: "remove lean clamp. we don't need it. release it."
    Gone properly rather than set to a large number: LEAN_CLAMP_FWD, LEAN_CLAMP_REAR and the
    LEAN_CLAMP max-of-the-two helper are deleted, along with the constrain on leanRaw and the
    conditional-integration freeze that was keyed to it. The two accumulator snapshots the freeze
    needed (posSetpointPrev, velocityLeanIPrev) go with it.
    WHAT STILL BOUNDS THE LEAN, because "no clamp" is not "unbounded" -- each term carries its
    own cap and their sum is the real ceiling:
    Kveff * velError ~ 2.0
    VEL_I_CLAMP = 14.0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
2026-08-19 Reset to v2-lean-baseline and remove the lean clamp
    balance_v2.ino reset to tag v2-lean-baseline, discarding the two experimental commits that
    sat on top of it (the stall-breakaway assist and its rework into a one-sided floor). Verified
    absent: no STALL_BREAKAWAY_ASSIST, no breakawayAssist, anywhere in the file.
    Then the lean clamp removed on top, as before: LEAN_CLAMP_FWD, LEAN_CLAMP_REAR and the
    LEAN_CLAMP max-of-the-two helper deleted, along with the constrain on leanRaw, the
    conditional-integration freeze keyed to it, and the two accumulator snapshots that freeze
    needed. Stale comments at LEAN_RATE_FF_MAX and above the snapshots updated.
    Reachable lean is now set by the per-term caps a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
    [balance_v2.ino]
2026-08-19 Soften the breakaway integral dump: keep half instead of zeroing
    The only change with direct flight evidence behind it, so the only one made.
    The stall->rolling edge discarded the ENTIRE velocity integral. Confirmed three times in one
    run, at the moment VF crosses VEL_I_ROLL_MIN:
    MS 16674 VELI 24.00 VF 0.12 -> MS 16774 VELI 0.37 VF 0.32
    MS 9054 VELI 24.00 VF 0.13 -> MS 9154 VELI 0.53 VF 0.46
    MS 13864 VELI -24.00 VF -0.09 -> MS 13964 VELI -0.10 VF -0.23
    and it RE-FIRES on every dip back under the threshold, which the same log does repeatedly
    (VF 0.32, 0.84, 0.46, 0.20, 0.34, 0.14, 0.23). That is "leans, moves, then forgets the lean",
    as a stick-slip c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
    [balance_v2.ino]
2026-08-19 Restore posSetpoint integration -- I deleted it removing the lean clamp
    REGRESSION I CAUSED, found by the pilot's log. Removing the conditional-integration freeze
    needed the two accumulator snapshots deleted with it, and I did that with a four-line range
    delete. The range was one line too wide and it took
    posSetpoint += targetVel * DT;
    which is THE DRIVE STICK'S ONLY PATH INTO THE LOOP. Without it posSetpoint never moves, so
    posError stays ~0, positionLean collapses to ~0, and the robot leans on the velocity integral
    alone and can never travel to a target.
    The log says it plainly, and the signature is worth remembering:
    TVEL -0.65 PSET 0.189 PERR -0.006 POS 0.195
    PSET is CON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
    [balance_v2.ino]
2026-08-19 Hysteresis on the rolling detector: the breakaway dump was firing several times per sample
    Softening the dump was not enough because it was firing far more often than once. The
    detector was a bare threshold test, `fabs(forwardVel) >= VEL_I_ROLL_MIN`, and VF dithers
    across 0.20 continuously once the robot is creeping. Every RISING crossing fires the dump,
    and at 200 Hz there can be several inside one 100 ms telemetry sample.
    Measured, this flight. VF across consecutive samples:
    0.03 0.08 0.11 0.15 0.17 0.36 0.26 0.14 0.25 0.10 0.28 0.13 0.26 0.15 0.31 ...
    and the effect in a SINGLE sample: VELI 14.00 -> 2.25. With VEL_I_BREAKAWAY_KEEP 0.5 one
    dump would give ~7. Two or three give 3.5 or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
2026-08-19 Breakaway integral dump fires once per engagement, not per slip
    The hysteresis band (e5682e9) fixed the sensor-dither chatter but not the
    real one: after breakaway the wheels stick-slip, so VF genuinely falls
    through the release threshold and climbs back through the rise threshold.
    Those are true stall->rolling edges and no band can reject them.
    2026-08-19 flight, four extra dumps after the real breakaway, each an
    exact halving:
    VELI 14.00 -> 7.60 | ~9.98 -> 4.99 | ~8.98 -> 4.49 | ~7.48 -> 3.74
    The integral then needed ~2 s of ramp to climb back to its 14 clamp. That
    tail is the "jitters a bit and then drives" the pilot reported.
    The policy was the bug. The dump sheds wind that was f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
    [balance_v2.ino]
2026-08-19 Back-EMF feedforward is common-mode only: it was a differential amplifier
    Per-wheel EMF FF fed each wheel from its OWN measured velocity, so the
    faster wheel was handed more pwm and pulled further ahead. Nothing opposed
    it: uL and uR are identical with no turn commanded, the friction floor is a
    single shared plainFloorFilt, and there is no wheel-speed matching anywhere
    in the loop. Deadbands are symmetric since the EN wiring repair, so this was
    the only asymmetric path in the output stage.
    Loop gain of the differential path = EMF_FF_GAIN / K_EMF = 35 / 43.6 = 0.80,
    which settles a differential disturbance at 1/(1-0.80) = 5.1x its true size.
    2026-08-19 flight, TCMD 0.00 throughout:
    VR-V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
2026-08-19 TURN_AUTHORITY 16 -> 32, VEL_I_CLAMP 14 -> 20
    Two constants on orthogonal axes, both directly requested.
    TURN_AUTHORITY: 16 was tuned while the per-wheel back-EMF feedforward was a
    differential positive-feedback loop of gain 0.80, multiplying any commanded
    turn by ~5x. "Turns are still faster" was measuring that amplifier, not this
    constant. Making the FF common-mode (6369cfb) removed the multiplier and the
    real authority showed up as sluggish rotation. 32 restores roughly a third of
    what the amplifier contributed -- deliberately not all of it, since the old
    feel was a feedback bug.
    VEL_I_CLAMP: the ramp is ceiling-limited, not rate-limited, so KVEL_I is the
    wrong knob. From the 2026-08-19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
    [balance_v2.ino]
2026-08-19 Fix stalled pivot wheel and the intermittent lean loss
    Two separate defects, both reported this flight.
    ONE WHEEL STALLS IN A PIVOT -- a mixing failure, not a weak turn.
    effortL = u + turnCmd, effortR = u - turnCmd, each floored independently by
    mapEffortToPwm. Counter-rotation requires the two efforts to have OPPOSITE
    SIGNS, i.e. |turnCmd| > |u|: the turn must beat the balance effort, not just
    reduce it on one side. Below that both wheels are driven the same way and one
    is merely weaker -- and if its |effort| falls under FLOOR_KNEE it receives a
    fraction of the floor, lands below breakaway, and sits.
    At TURN_THROTTLE_FLOOR 0.30 a stationary pivot had turnCmd = 0.30 * 32 = 9.6
    against a |u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
    [balance_v2.ino]
2026-08-19 DRIVE_MAX_VEL 0.65 -> 0.90: lean at speed needs acceleration demand left
    Every discrete lean wipe is now gone: the breakaway dump fires once per
    engagement, `driving` is debounced against RC dropouts, DRIVE_LAUNCH_ASSIST is
    0 so its velocity-gated block is inert, and posSetpoint has always been clamped
    to positionRev +/- POS_ERROR_CLAMP so there is no hidden position debt.
    What remains is the outer loop arriving. As forwardVel reaches targetVel:
    velError -> 0 so velocityLean -> 0; velocityLeanI stops growing and unwinds at
    KVEL_I * |velError| = 24 deg/s per rev/s of overshoot; posError swings +1.5 ->
    -1.5 as positionRev outruns posSetpoint, carrying positionLean +9 -> -9.
    Lean is the accel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
    [balance_v2.ino]
2026-08-20 Rewrite README for the Teensy/CRSF cascade build
    The README still described the Uno bench tester: Uno pinout, 90-100 mm wheels,
    no radio at all, LEAN_CLAMP 5.0, Kpos 1.0 / Kvel 4.0, MAX_PWM 110, a single
    MOTOR_DEADBAND of 11, and the old regulator control law
    leanRaw = -(Kpos*positionRev + Kvel*forwardVel). None of that is current.
    Now documents: Teensy 4.1 pinout and 3.3 V encoder supply, the TX16S/ELRS
    channel map, the cascade (stick -> velocity -> position setpoint -> lean ->
    pitch PD), the output stage (continuous friction floor + common-mode back-EMF),
    the real constants, the expanded grouped telemetry format, all seven test
    harnesses, and the flash.sh workflow.
    Also records the thing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
2026-08-20 Add demo clips to the README
    Two 10 s clips: the robot balancing on the floor, and a bench run with the
    TX16S and the telemetry stream on screen.
    Committed in both formats. GIF renders inline on GitHub but is a poor fit for
    handheld 1080p -- there is no static background for inter-frame compression to
    exploit, so a straight 640 px / 12 fps encode came out at 58 MB and 31 MB. The
    committed GIFs are cropped to the subject, denoised, 360 px, 8 fps, 64 colours:
    4.8 MB and 2.8 MB. The MP4s are the same ten seconds at full 30 fps and 720 px
    for 2.4 MB and 1.5 MB, and GitHub plays them in its file view.
    Also marks jpg/gif/mp4 as binary in .gitattributes. The repo sets
    `* text=auto eol=lf` and onl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
2026-08-21 Spec the DJI O3 Air Unit FPV payload integration
    The V1 PoC BOM has always listed a DJI O3 Air Unit as the FPV payload, but
    nothing in the repo said what the robot has to provide for it. This is that
    document: power, mounting, cooling, RF, and the effect on the balance tune.
    Three findings worth pulling out of it:
    - The BOM's "dedicated BEC/regulator for DJI O3" line is wrong. The O3 takes
    7.4-26.4 V, so a 4S pack is inside its input window across the whole
    discharge curve. It needs a fused, filtered, star-fed branch off the pack --
    not a regulator, and definitely not the 5 V logic rail, which is below its
    minimum input.
    - Cooling is a requirement, not a mount to reserve. The O3 i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
2026-08-21 Confirm the O3 cable colours against the physical cable
    The cable in hand carries red / black / white / grey / brown / yellow as pins
    1-6, matching the pinout the spec already documented. Closes open item 3.
    Colour-coded wires plus a keyed connector at the O3 end mean the mapping is
    determined by colour rather than by counting pins, so the mirrored-pinout
    hazard the warning was aimed at does not apply here. What is left is a
    continuity check from each bare wire to its connector pin -- the one thing
    colour cannot tell you -- and insulating the four unused wires individually
    rather than as a bundle during the power-only bring-up stage.
    Cl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
2026-08-21 Correct the O3 connector: JST-SH 1.0 mm, not JST-GH 1.25 mm
    The spec called the 6-pin power/UART connector JST-GH 1.25 mm. That is the
    previous generation -- the DJI FPV Air Unit V1 and the Caddx/RunCam Vista used
    the 1.25 mm pitch part. The O3 shrank ~40 percent and moved to 1.0 mm pitch,
    6-pin JST-SH. The two do not intermate, so the old figure would have bought the
    wrong part for the extension the layout section calls for.
    Manufacturer part listings settle it: Flywoo, Pyrodrone and the generic kits all
    ship "JST-SH 1.0mm 6-pin" cables specifically for the O3. A couple of secondary
    write-ups still say GH 1.25 for the O3; they are describing the old air unit.
    Adds a sourcing note while he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
2026-08-21 Expand section 9: activation and the pairing procedure
    The spec said "bind it" in one line and left the actual procedure implicit,
    which is the part that matters for Stage A -- power-only is the whole of the
    video path, so pairing is the only other thing standing between two wires and a
    picture.
    Adds three things:
    - An explicit statement that the video link is air-unit-to-goggles and involves
    no flight controller at any point. The UART only adds the OSD overlay and the
    arm flag. This is what makes the power-only stage worth doing first.
    - Activation as its own step. A new unit reports limited functions until it is
    activated over USB-C in DJI Assistant 2, and correct wiring will not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
2026-08-21 Target DJI Goggles 3: firmware gates and the ELRS 2.4 GHz consequence
    The goggles for this build are Goggles 3, which pins down two things the spec
    had been carrying as generic caveats.
    Firmware, as hard gates rather than advice: Goggles 3 gained O3 support in
    v01.00.0300, and the air unit must be >= V01.02.0000 or it will not bind at all
    -- silently, with no useful error. New-old-stock units are likely to ship below
    that, so the air unit should be assumed to need updating before it will ever
    talk to these goggles. Both need a power cycle after updating. The bind menu
    path also differs from Goggles 2: Settings -> Transmission -> Bind, with the air
    unit's LED blinking rapidly first, so the p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
2026-08-21 Add section 13: getting the video onto a PC, and why not via SDR
    The O3 downlink is AES-256 with a per-power-on session key over an undocumented
    LTE-like OFDM layer. There is no open receiver and no public break of the video
    payload, so an SDR capture yields a spectrogram and nothing more.
    A HackRF is the wrong instrument twice over before the crypto even matters: 20
    Msps against a link that runs 20 and 40 MHz channels, so the 40 MHz mode is
    physically uncapturable and 20 MHz leaves no oversampling headroom, plus an
    8-bit ADC against high-PAPR OFDM, at the top edge of its frequency range where
    it is least sensitive. For scale, the NDSS 2023 team used a USRP B200mini and
    what they recovered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
2026-08-21 Record two decisions: goggles-to-PC for test capture, CV on its own board
    Both questions section 13 raised are now settled, so they are written down as
    decisions rather than left as options to re-argue.
    The PC feed is for test capture and review only, routed goggles to PC, with
    nothing downstream depending on its latency or on DJI keeping the route open.
    Notes that the free Goggles 3 DVR is enough if reviewing runs afterwards is all
    that is wanted -- the USB-C route earns its cost only for video and the 100 ms
    telemetry stream live on one screen together. That combination is genuinely
    useful here given how much of the tuning was read off the scrolling telemetry,
    so it suggests capturing bot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
2026-08-21 Argue the UART case in section 3.3 rather than just listing it
    The section said what the two signal wires buy but never made the argument, and
    the strongest reason was missing entirely.
    That reason is this repo's own debugging method. Every troubleshooting entry in
    the README ends in reading the 100 ms telemetry stream -- which of the outer-loop
    terms saturated, whether VELI stepped or slid, whether a stalled wheel is a
    torque null or a lost sign contest. That works today because the robot sits on a
    box next to the monitor. Under FPV it does not: the symptom arrives in the
    goggles and the state that explains it is on a screen in another room. MSP
    DisplayPort is what keeps the method once th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
2026-08-21 Clarify section 14: the air unit is PC-only, the goggles are not
    The O3 Air Unit product download page lists manuals, release notes and phone
    apps, which reads as though the whole thing is a phone job. It is not, and the
    two devices genuinely differ:
    - O3 Air Unit: activation and firmware are PC/Mac only, over USB-C into DJI
    Assistant 2. No phone path, no over-the-air path, and it cannot be updated
    through the goggles.
    - Goggles 3: either DJI Fly on a phone over the OTG cable, or Assistant 2 on a
    PC.
    Adds that split as a table at the top of section 14, and explains the specific
    trap: the desktop installer is not on the product page at all. DJI keeps
    Assistant 2 on its own software pa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
2026-08-21 Add 7.6: head tracking, and what a panning camera would cost
    The Goggles 3 do have a head-tracking IMU, but the feature is gated to DJI's own
    aircraft where DJI owns both ends. On a custom O3 build there is no documented
    path for head angles to reach our own controller, and pin 6 carries channels
    from a bound DJI remote rather than head orientation -- which is moot here
    anyway, since control is ELRS from the TX16S.
    Flagged as "no known route" rather than "impossible": this is not confirmed from
    a primary DJI source, and the evidence is circumstantial -- community threads
    asking for it end without a solution, and external head trackers are sold
    specifically for O3/O4, which would be a strang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
2026-08-21 State plainly that there is no cable between goggles and air unit
    Section 9.3 gave the binding procedure without ever saying what the connection
    physically is. The link is the wireless 5.8 GHz downlink; the only USB-C cables
    involved run from a computer to one device at a time for activation and
    firmware, never between the two. So "connecting them" means binding once, after
    which they find each other on power-up and the binding survives power cycles and
    remounting.
    Also replaces the bare "binding survives power cycles" line with what a normal
    connection looks like -- image within a few seconds, LED solid, nothing pressed
    -- and the order to check when it does not come up: both powered, the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
2026-08-22 Add the Teensy UART map, and stop asserting firmware version numbers
    Three changes, two of them corrections.
    Section 3.2 now carries the full Teensy 4.1 UART pin map, taken from the core
    source rather than memory, checked against every pin this project uses. Eight
    hardware UARTs, one in use, so no external board is needed for the O3 -- this is
    the migration's stated headroom being spent. Also flags that Serial2 and Serial4
    overlap in the core's alternate pin tables, so both must not land on the same
    physical pins.
    Section 9.2 previously stated a hard air unit minimum of V01.02.0000. Sources
    disagree -- reported minimums range to v01.03.0000 -- and since the two devices
    speak a protocol tha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
2026-08-22 Correct section 9.3: binding needs VBAT, USB-C is not enough
    The spec said to bind at the desk with the air unit on USB-C. That looks wrong.
    USB power is enough for the unit to enumerate to a PC, which is all activation
    and firmware need, but reports are that on USB the air unit stays dormant and
    never transmits -- so the goggles never see it and the bind cannot complete.
    Binding needs the radio up, which needs VBAT on pins 1 and 2: the pack, a spare
    3S/4S, or a bench supply around 12 V.
    Flagged as secondary-source confidence rather than asserted, with the ten-second
    test that settles it: power from USB alone and watch whether the LED ever
    reaches the booted state.
    This splits the desk wor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
2026-08-24 Add the air unit LED state table to section 9.3
    The bind procedure referred to LED states without ever defining them, which
    makes the one diagnostic signal the air unit gives you unreadable. Green is
    booting, solid red is booted and unlinked, blinking red is actively linking, and
    solid green is linked.
    The useful reading: blinking red is the good state mid-bind, not an error. An
    air unit that blinks red indefinitely without reaching solid green is doing its
    half correctly and the goggles are not completing -- which points at the section
    9.2 firmware gate rather than a hardware fault. Also notes it is transmitting
    while it searches, so it should not be left in that state on the bench without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
2026-08-24 Add 9.3.1: working the "goggles cannot find the air unit" failure
    This is the common bind failure and the spec had no ordered procedure for it.
    Roughly 90 percent of cases are a firmware mismatch: the two devices speak a
    proprietary protocol that changes between releases, and reports are the versions
    need to be within about one minor revision, so a mismatch produces silence
    rather than an error.
    Below that, the free checks worth two minutes before reaching for a PC: sources
    disagree on whether the goggles enter pairing via Settings, Transmission, Bind
    or by holding the power button until they beep, but either way both devices must
    be searching simultaneously and the goggles should go first;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
2026-08-24 Sharpen the bind diagnosis: blinking red has two meanings
    The LED table called blinking red "actively linking", which is only true if you
    pressed the link button first. Blinking red on its own from power-up is not link
    mode, and on an unactivated unit that is exactly what it does -- an unactivated
    O3 will not transmit at all and cannot set functions or channels, so the goggles
    cannot find it however many times bind is pressed.
    That also reorders 9.3.1. Activation is now first rather than second: it is a
    hard gate rather than a degraded mode, and a new O3 is not activated out of the
    box.
    Adds the bisection the goggles give you for free, which splits the failure in
    one step: no O3 option in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
2026-08-24 Record the known-good O3 / Goggles 3 firmware pairing
    Earlier this section refused to name versions because sources disagreed. The
    release notes settle it: O3 Air Unit v01.03.0000, dated 25 July 2024, is the
    release that added DJI Goggles 3 and FPV RC3 support, and Goggles 3 v01.00.0300
    is its counterpart. Those are the floors; later is fine. The instruction stays
    "update both to latest and power-cycle both", with the versions as reference
    points rather than targets.
    Adds the distinction that actually matters at the bench: firmware version and
    activation are independent gates. A unit can sit on current firmware and still
    be unactivated, and an unactivated unit does not transmit at all -- so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
2026-08-24 Add blink-rate and proximity checks, and the Goggles 3 link-recovery risk
    Two checks that a bind attempt can fail on silently, now in 9.3.1 above the
    button-pressing: the blink RATE distinguishes bind mode from firmware-update
    mode -- rapid is bind, slow is update and is not bindable -- so "blinking red"
    alone does not tell you the unit is trying to bind. And binding has a proximity
    requirement of about a metre; being across the bench fails it without saying so.
    Separately, a finding that bears on the UART decision rather than on binding.
    There are reports that with O3 and Goggles 3, after a video signal loss the link
    does not re-establish until the air unit receives a disarm over MSP Displ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
2026-08-24 Correct the Goggles 3 bind procedure against the real menu
    The spec told you to use "Settings -> Transmission -> Bind". That item does not
    exist on this firmware. Many write-ups claim it does, which is how it got in
    here. On Goggles 3 the Transmission menu selects Pilot or Audience, the device
    is chosen under Status -> Switch model, and the bind is triggered by pressing and
    holding the goggles' power button until they beep -- there is no menu entry for
    it at all.
    The rewrite also puts the actual trap first. In Audience mode the goggles are
    trying to watch another pair's broadcast rather than own an air unit, and
    audience goggles cannot bind to an air unit at all. If Transmission is set to
    A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
2026-08-24 Mark the bind procedure bench-verified; Stage 0 complete
    The Goggles 3 sequence in 9.3 is now confirmed working on real hardware rather
    than assembled from sources: Goggles 3 v01.00.1400 with O3 v01.03, both
    activated, bound via Pilot mode, Status -> Switch model -> Air Unit 3, and the
    power-button hold. The widely published "Transmission -> Bind" path does not
    exist on this firmware.
    Closes open item 5b with the outcome that matters for anyone reading this later:
    firmware was never the blocker. Both devices were already current and activated
    throughout, and the whole evening was the wrong bind procedure. Worth recording
    because the firmware hypothesis is the one every guide reaches for fir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
